helper15901590/game-story/项目说明与二次开发指南.md

# 冒险故事机（Story Machine / iStory）项目说明与二次开发指南

> 整理日期：2026-11-13
> 依据材料：V1.0、V2.0 两个版本目录中的固件源码、PRD、NFC 数据结构表、编码命令、BOM、烧录教程与示例内容。
> 用途：帮助新接手的人快速理解项目，并为二次开发（内容 / 固件 / 硬件 / 配套工具）做准备。

---

## 0. 一页速览

**这是什么**：一台无屏、以 NFC 卡片为载体的儿童互动有声故事机。孩子把故事卡插入卡槽，机器读取卡内的"剧情节点表"，再从 TF 卡播放对应的音频；故事进行到决策点时，旋转旋钮试听选项、按下确认，实现"选择推动剧情"的互动叙事。

**核心原理一句话**：

> NFC 卡里存的不是音频，而是**剧情跳转表**；音频全部放在 TF 卡里。MCU 读卡决定"现在播哪个文件、播完跳到哪里"。

**产品形态**：
- 硬件：圆角小主机 + 多功能旋钮（旋转/按压/长按）+ 插卡槽 + 知识/插播按键 + RGB 状态灯 + Type-C 充电。
- 内容：一张 NFC 卡 = 一个故事；TF 卡里一个 5 位数字文件夹 = 一个故事的全部音频。
- 商业模式（投资人材料）：硬件为入口、NFC 故事卡为持续复购内容（剃刀-刀片模式）。

**两代版本**：
| 版本 | 目录 | 核心玩法 | 提供物 |
|---|---|---|---|
| V1.0 选项插播 | `V1.0 选项插播 20251125/` | 每个选项(O)可插播知识音频(K) | 完整开发+生产资料（源码、PCB、BOM、语音芯片固件、TF 内容） |
| V2.0 主音插播 | `V2.0 主音插播 20251213/` | 插播绑定到主线音频(M)，并新增 3-5 岁"ISTORY mini"模式 | **只有烧录 hex 与文档，没有源码** |

**技术栈**：Nuvoton MS51EC0AE（1T 8051，32KB Flash / 2KB SRAM，24MHz）· Keil C51 · RC522（SPI，NTAG216 卡）· WT2003H4-16S（UART 语音芯片，读 TF 卡）· 2000mAh 锂电池 · 编码器旋钮。

---

## 1. 目录结构怎么读

```
game story/
├─ V1.0 选项插播 20251125/
│  ├─ audio storyV1.0.md          ← V1 产品需求文档（PRD V4.0 + 编码规范附录）
│  ├─ audio storyV0.1~V0.3.md     ← 早期需求迭代稿（历史参考）
│  ├─ NFC写入教程/                 ← NFC 命令写入视频、数据结构表、命令示意
│  ├─ 代码烧录1114/                ← 烧录演示照片/视频、量产 hex、TF卡文件.zip
│  │   └─ Story_machine 251127 L3/Story_machine V1.hex
│  ├─ 其他资料/                    ← 样音（小红帽/我的世界/村庄任务/晚安妈妈）、调研、路演稿
│  ├─ 内容改编/                    ← 四大名著原文（内容改编素材）
│  ├─ 结构与外观/                  ← 外观渲染图、结构件 ZIP（V0.1~V1.1）、紧固件清单
│  └─ 开发生产文件/故事机251117 L1.0/
│      ├─ 开发文件/
│      │   ├─ 硬件/Story_machine V1.3/   ← Altium PCB 源文件
│      │   ├─ 软件/Story_machine/        ← ★ 主控 Keil 工程（本项目的核心代码）
│      │   └─ 语音/                      ← WT2003 芯片手册、语音芯片固件 .fw、NFC数据结构.xlsx
│      ├─ 生产文件/                      ← 量产 hex、BOM、PCB、拼板/贴片资料
│      └─ 说明.txt                      ← "生产文件用于生产，开发文件除开发人员请勿动"
│
└─ V2.0 主音插播 20251213/
   ├─ audio storyV2.0.md          ← V2 PRD（ISTORY 6-12 岁 + ISTORY mini 3-5 岁）
   ├─ 优化记录.docx                ← ★ V2 改版决策清单（信息量最大）
   ├─ [1]代码及烧录/IStory V2.0 20251209.hex   ← 仅 hex，无源码
   ├─ [2]NFC编码及写入/            ← V2 NFC 数据结构 L2.0
   ├─ [3]配件及规格/ [4]结构及外观/ ← 与 V1 基本相同的硬件/结构资料
   └─ [5]内容及示例/               ← 村庄任务示例（脚本+音频+编码命令）、四大名著
```

**最重要的三个目录**：
1. `V1.0 .../开发文件/软件/Story_machine/` —— 唯一一份主控源码。
2. `V1.0 .../开发文件/语音/` —— 语音芯片固件与 NFC/TF 数据规范。
3. `V2.0 .../优化记录.docx` —— 理解 V2 为什么这样改的钥匙。

---

## 2. 系统架构与硬件

### 2.1 系统框图

```
        ┌──────────────┐   SPI(软件模拟)   ┌──────────────┐
        │              │◄─────────────────►│  RC522 Mini  │◄──► NTAG216 故事卡
        │              │  RST/NSS/SCK/MOSI │  (13.56MHz)  │      (卡片插入卡槽，
        │ MS51EC0AE    │  /MISO            └──────────────┘       压住触位开关)
        │ 8051 24MHz   │
        │              │   UART 9600        ┌──────────────┐
        │              │───────────────────►│ WT2003H4-16S │──► TF 卡（音频）
        │              │  TX/RX/BUSY        │  语音芯片     │──► WT8302 功放 ──► 4Ω3W 喇叭
        │              │                    └──────────────┘
        │              │   GPIO
        │              │── 编码器 A/B + 按压、插卡触位开关、插播按键
        │              │── RGB 三色灯（R/G/B）、按键指示灯
        │              │── 电池检测（TP4056：CHRG/STDBY）、ADC 电量
        └──────────────┘
                 │
              Type-C 充电 / 2000mAh 锂电池
```

### 2.2 关键器件（来自生产 BOM）

| 类别 | 型号/规格 | 说明 |
|---|---|---|
| MCU | Nuvoton **MS51EC0AE**（SOP-28，32KB Flash，2KB SRAM，1T 8051） | 无外挂 Flash；Keil 工程按 24MHz 主频 |
| NFC 读头 | **RC522 Mini** 模块 | BOM 注明"定制去掉模块上的 LED 以降低功耗" |
| NFC 卡 | **NTAG216**（国产 868 字节 / 进口 888 字节） | ISO14443-3A，带密码保护 |
| 语音芯片 | **WT2003H4-16S**（SOP-16，带 TF 卡版本 A02） | 主控固件 `WTC221031-72-A02V2.05.fw`，校验码 86A87450 |
| 功放 | WT8302（SOP-8） | 驱动 4Ω/3W 喇叭 |
| 充电管理 | TP4056（1A） | 提供 CHRG / STDBY 状态给 MCU |
| LDO | HL5933XR（SOT-23，500mA） | 3.3V 稳压 |
| 旋钮 | 三色 RGB 带按压编码器 `ED1273S-RGB-24P-24LC-Y20A7` | 旋转 + 按压 + 三色灯 |
| 存储 | TF 卡 C10（BOM 为 16GB；PRD 写 32GB） | FAT32，存放全部音频 |
| 电池 | 2000mAh 3.7V 刀片/立柱式锂电池（带保护板） | 满电 4.2V |
| 喇叭 | 4Ω 3W（V1 带线端子；V2 为 Φ2.5cm 内磁喇叭） | |
| 按键 | 6×6×9 带灯轻触按键 | 插播/知识键，带黄色指示灯 |

### 2.3 MCU 引脚分配（来自 `MS51_16K.h` 与 `GPIO_Init()`）

| 功能 | 引脚 | 配置 |
|---|---|---|
| RC522 RST | P2.3 | 推挽输出 |
| RC522 NSS(CS) | P1.1 | 推挽输出 |
| RC522 SCK | P1.2 | 推挽输出 |
| RC522 MOSI | P3.5 | 推挽输出 |
| RC522 MISO | P2.1 | 准双向 + 上拉 |
| 语音芯片 TX（MCU 发） | P0.6 | 推挽输出（UART0 TX） |
| 语音芯片 RX（MCU 收） | P0.7 | 输入（UART0 RX） |
| 语音芯片 BUSY | P0.4 | 输入；**播放时为高，空闲为低** |
| 编码器 A 相 | P3.0 | 外部中断 INT0，下降沿 |
| 编码器 B 相 | P1.7 | 外部中断 INT1，下降沿 |
| 旋钮按压键 | P3.4 | 准双向 + 上拉 |
| 插卡触位开关（NFC 键） | P0.3 | 准双向 + 上拉；**卡插入=按下** |
| 插播/知识按键 | P3.3 | 按键输入 |
| 插播按键指示灯 | P2.4 | 推挽输出 |
| RGB 灯 R / G / B | P0.1 / P0.0 / P1.0 | 共阴，**1=亮，0=灭**（PWM 做呼吸灯） |
| 充电检测 CHRG | P2.5 | 输入 + 上拉；充电时=0 |
| 充满检测 STDBY | P1.4 | 输入 + 上拉；充满时=0 |
| 电池电压采样 | P0.5 | ADC（代码使能 CH4） |

> 烧录：板上有 5Pin 排针（3.3V / GND / RX / TX / GND），用 **Nu-Link Plus** 连接，配合 Nuvoton 工具/Keil 烧录。详见 `代码烧录1114/烧录代码教程.mp4` 与 1/2/3.jpg。

---

## 3. 主控固件（V1.0 源码）

### 3.1 工程与构建

- 工程：`.../开发文件/软件/Story_machine/Project/Story_machine.uvproj`
- IDE/编译器：**Keil uVision 5（V5.24.2）+ C51 PK51 9.57**；CPU 选 `MS51EC0AE`，时钟 24MHz。
- 输出：`Output/Story_machine V1.hex`；构建日志显示 `code=17458 bytes, data=42.4, xdata=511`。
- 源码编码：**GBK**（用 UTF-8 打开会乱码，需转码或用支持 GBK 的编辑器）。
- 调试宏：`UART0_DEBUG`、`RC522_DEBUG` 默认均为 0（在 `MS51_16K.h` 中）。注意 UART0 与语音芯片共用（P0.6/P0.7），打开调试打印会把日志同时发给 WT2003，可能干扰播放，调试时需注意。

### 3.2 文件职责

| 文件 | 职责 |
|---|---|
| `APP_Driver/Main/main.c` (1482 行) | **业务核心**：主循环、按键功能分发、故事状态机、休眠/低电、LED 调度 |
| `APP_Driver/Main/Function_Loop.c` | 早期框架，基本全部注释，可忽略 |
| `APP_Driver/RC522/RC522.c / RC522.h` | RC522 底层驱动（SPI 时序、寄存器、寻卡/防冲突/读写/密码认证） |
| `APP_Driver/RC522/RC522_Function.c` (1141 行) | 业务封装：`Rc522_Read_NTAG216_Full()` 读一页（底层返回16字节，仅用前4字节）、`Rc522_NTAG216_Password_Verify()` 验证密码+验证码 |
| `APP_Driver/WT2003/WT2003.c` | 语音芯片 UART 协议封装（A3/A4/A5/B1/AA/AB/AE/B6） |
| `APP_Driver/KEY/Key.c` | 按键扫描：短按/长按/拨码型，输出键值 |
| `APP_Driver/LED/LED.c` | 12 种灯效模式 + 提示灯 + PWM 呼吸灯 |
| `APP_Driver/Sleep/Sleep.c` | 掉电休眠、引脚唤醒（旋钮键/充电插入等） |
| `Library/Device/...` | Nuvoton MS51 官方头文件/SFR 宏（引脚别名也在这里） |
| `Library/StdDriver/...` | Nuvoton 标准外设库（GPIO/UART/ADC/Timer/I2C/SPI/EEPROM 等） |

### 3.3 主循环与中断

`main()` 初始化后进入死循环：

```c
while (1) {
    Encoder_Process();          // 编码器事件锁
    key_scan();                 // 按键扫描（Timer 计数去抖）
    utime_1s_function();        // 1s 计时：休眠 / 60s、120s 提示 / 180s 关机
    KEY_function();             // ★ 所有业务按键分发
    volume_control_funtion();   // 调音量后 5s 播放"噔"提示音
    busy_end_clr();             // ★ 检测 BUSY 下降沿，推进故事状态机
    LED_function();             // 电量/充电灯逻辑
    LED_MODE_Select();
    LED_PWM_Duty_RUN_program();
    TIPLED_MODE_Select();
}
```

- **Timer0**：约 2.738ms 中断，390 次 ≈ 1s（系统时基）。
- **Timer1**：约 2.73ms 中断，39 次 ≈ 100ms（按键/LED 扫描时基）。
- **UART0 中断**：接收语音芯片应答到 `RevBuffer`。
- **INT0/INT1**：编码器 A/B 相，产生顺时针 `0xD0` / 逆时针 `0xD1`。
- **Pin Interrupt**：休眠唤醒。

### 3.4 键值定义

| 键值 | 含义 | 触发条件 |
|---|---|---|
| `0xB0` | 拔卡（触位开关松开） | P0.3 松开 40ms |
| `0xB1` | 插卡（触位开关按下） | P0.3 按下 40ms |
| `0xC0` | 旋钮短按 | 松开时判定（<1s） |
| `0xC1` | 旋钮长按 | 按住 ≥ 40000 次扫描（代码注释称约 1 秒，PRD 写 3 秒；实际时长取决于主循环周期，需实测） |
| `0xD0` | 旋钮顺时针 | INT0 中断 |
| `0xD1` | 旋钮逆时针 | INT1 中断 |
| `0xE0` | 插播/知识键短按 | 松开时判定 |
| `0xE1` | 插播/知识键长按 | 按住 ≥ 1s |

### 3.5 V1 故事播放状态机（核心）

关键变量：

| 变量 | 含义 |
|---|---|
| `Story_Number` | 故事编号（由 NFC 页 04 的 BCD 数据解码，1~9999） |
| `Story_nodes_state` | 当前 M 节点号（1~255） |
| `branches_ALLNumber` | 当前节点选项数（0~3） |
| `branches_Number` | 当前试听到第几个选项（0=未选） |
| `branches_play_flag` | 0=空闲/播完，1=主音频播放中，2=暂停，3=验证音效播放中 |
| `End_play_flag` | 1=待播剧终音效，2=剧终音效播放中 |
| `b_Automatic_Continuation` | 无选项时自动连播下一 M |
| `B_Skipped_flag` | 已执行"跳过" |
| `NFC_flag` / `KEY_NFC_flag` | 开机时卡是否已插入 / 读卡失败标记 |

流程（简化）：

```
插卡(0xB1)
  └─ 密码验证 + PACK 校验（22）
      ├─ 失败：红灯闪两下 + 音效 0004，进入"音量模式"
      └─ 成功：白灯常亮
          读页 04 → 故事编号
          读页 05(M1) → 选项数
          播放 0005"验证通过" → 播完自动播放 M1
              ├─ M 播完且无选项：
              │    ├─ block2=0 → 标记剧终，播放 0011 后回到待机
              │    └─ block2≠0 → 自动连播该 M 节点（线性播放）
              └─ M 播完且有选项：
                   ├─ 旋转 → 循环试听 O1..On（播放文件 "<M>1..<M>3"）
                   │    └─ 短按插播键 → 播 K 音频 "<M>A..<M>C"（V1 选项插播）
                   └─ 按下旋钮 → 按所选 O 的跳转目标进入下一 M
拔卡(0xB0)
  └─ 停止播放 + 音效 0006 + 呼吸灯 + 清空全部状态
```

补充规则（V1 代码）：
- 短按旋钮：主音频播放中=暂停/续播；选项试听中无效；播完后=确认当前选项。
- 长按插播键：跳过当前主音频剩余部分（若在自动连播节点则只跳一次）；结局音频不可跳过。
- 长按旋钮：关机（播放 0002）。
- 未插卡时旋转旋钮=音量 10 级（映射 0,5,10,13,16,19,22,25,28,31）；插卡且主线播完时旋转=切换选项。
- 开机后若卡已插着，播完开机音效自动触发一次读卡。

### 3.6 LED / 电源 / 休眠（V1）

- 灯效编号：1 全灭、2 白色呼吸、4 白常亮、5 红灯闪两下接灭、6 红灯闪两下接呼吸、7 红常亮、8 绿常亮、9 蓝常亮、11 蓝闪两下接白常亮、12 蓝闪两下接红常亮。
- 充电：充电中红灯常亮，充满绿灯常亮；充电时不进入休眠。
- 低电：代码用 ADC 均值判断，阈值 2200/2100（注释称 3.5V/3.3V，实际是 ADC 码值），≤20% 红灯闪+音效 0009，≤10% 音效 0010 后自动关机。
- 休眠：开机空闲 60s/120s 播 0008 提醒，180s 自动关机；关机状态 10s 后 MCU 掉电，由引脚中断（旋钮键/充电插入）唤醒。

> 注意：PRD 的电量百分比是产品口径，代码里没有库仑计，只有电压估算，实际阈值需按电池曲线标定。

### 3.7 代码风格与注意点

- 典型 8051 风格：大量全局变量、`bit` 标志、`UINT8/UINT16` 自定义类型；业务逻辑集中在 `main.c` 的 `KEY_function()` 与 `busy_end_clr()`。
- 大量中文注释，但有拼写/乱码；`tempCodeRunnerFile.c/h` 是编辑器残留空文件。
- 无 RTOS、无单元测试，全靠整机联调；改动后必须做完整回归（见 §9.4 测试清单）。

---

## 4. 语音芯片 WT2003H4-16S 与音频协议

### 4.1 分工

MCU 不直接解码音频：所有播放指令通过 **UART0（9600 8N1）** 发给 WT2003H4-16S，芯片自己读 TF 卡、解码 MP3/WAV，经 DAC/SPK 输出（固件启动时发 `B6 01` 切到 DAC 输出，再经 WT8302 功放）。`BUSY` 引脚高电平表示正在播放，是故事状态机的关键输入。

### 4.2 固件中实现的命令（`WT2003.c`）

帧格式统一：`7E | 长度 | 命令 | 参数... | 校验和 | EF`，校验和 = 从"长度"到最后一个参数字节之和（取低 8 位）。

| 命令 | 作用 | 本项目用途 |
|---|---|---|
| `A3` | 指定根目录文件名播放 | 预留 |
| `A4` | 指定文件夹按索引播放 | 预留（插播按键旧方案） |
| `A5` | 指定文件夹内文件名播放 | **主用**：故事音频、系统音效 |
| `AA` | 暂停/继续 | 短按旋钮暂停/续播 |
| `AB` | 停止 | 预留 |
| `AE` | 音量 0~31（掉电记忆） | 10 级音量映射 |
| `B1` | 播放中插播（播完自动恢复原曲） | V1 PRD 曾设想，代码未启用 |
| `B6` | 输出切换：00=SPK，01=DAC | 开机切 DAC |

### 4.3 三种播放函数

```c
// 1) 故事音频：文件夹=故事编号，文件=节点号+选项位
volume_Play_TF(Story_Number, Node, Option);
//   发送 "00" + 3位故事号 + 3位节点号 + 1位选项号
//   例：volume_Play_TF(1, 4, 0) → 文件夹 00001，文件 0040.mp3（M4 主音频）
//       volume_Play_TF(1, 4, 2) → 0042.mp3（M4 的 O2）
// 2) 选项对应的知识音频（V1）：选项 1/2/3 → 字母 A/B/C
volume_Play_TF_option(Story_Number, Node, Option);
//   例：(1, 4, 1) → 004A.mp3（M4 的 K1）
// 3) 系统音效：固定文件夹 SYSTE
volume_Play_TF_SYS(0,0,0,5);   // → SYSTE/0005.mp3
```

### 4.4 TF 卡目录与命名（V1 实机口径）

```
TF 卡根目录/
├─ SYSTE/                 ← 系统音效，固定 5 字符大写
│   ├─ 0001.mp3  开机
│   ├─ 0002.mp3  关机
│   ├─ 0003.mp3  音量调节
│   ├─ 0004.mp3  读卡错误
│   ├─ 0005.mp3  读卡成功
│   ├─ 0006.mp3  拔卡
│   ├─ 0007.mp3  跳过
│   ├─ 0008.mp3  等待 1/2 分钟提醒
│   ├─ 0009.mp3  电量≤20%
│   ├─ 0010.mp3  电量≤10%
│   └─ 0011.mp3  剧终
└─ 00001/                 ← 故事文件夹：首位 0 + 故事编号
    ├─ 0010.mp3          M1 主音频
    ├─ 0011.mp3 / 0012.mp3 / 0013.mp3   M1 的 O1/O2/O3
    ├─ 001A.mp3 / 001B.mp3 / 001C.mp3   M1 的 K1/K2/K3（V1）
    ├─ 0020.mp3          M2 主音频
    └─ ...
```

命名规则：**文件前 3 位 = M 节点号，第 4 位 = 类型**（`0`=主音频/结局，`1~3`=选项，`A~C`=知识插播）。结局音频与普通 M 共用命名，只是 NFC 数据标记为终止节点。

音频要求（文档口径）：MP3/WAV，8kHz~44.1kHz，单声道，8kbps~320kbps；推荐 MP3。实机样音多为 32~64kbps 单声道。

---

## 5. NFC 数据协议（NTAG216）

### 5.1 存储布局（先厘清"页"与"扇区"）

NTAG216 的读写单位是 **页(page)，每页 4 字节**；NFC Tools Pro 的 `A2:XX:....` 就是"向第 XX 页写 4 字节"。

项目文档里说的"每个 M 节点占 1 个扇区 / 4 个 Block"，实际指的是**一页 4 字节**，不是 16 字节。固件 `Rc522_Read_NTAG216_Full(page)` 底层 `PcdRead()` 一次会返回 16 字节（4 页），但业务代码**只用 `RevBuffer[0..3]` 这 4 个字节**，后面的数据被忽略。理解了这一点，写卡地址才不会算错。

| 页地址 | 用途 |
|---|---|
| 00~03 | 厂家信息 / UID / 静态锁（不可改） |
| 04 | 故事元数据（4 字节：故事编号高/低 + 主音频数量高/低） |
| 05 起 | M1、M2、M3… 每个 M 节点占 **1 页（4 字节）**；页号 = M 节点号 + 4 |
| E3~E6 | 配置区：CFG0 / CFG1 / 密码(PWD) / 验证码(PACK) |

### 5.2 页 04：故事元数据

| 字节 | 字段 | 说明 |
|---|---|---|
| 1 | 故事编号高位 | **BCD 编码**的两位十进制数（如 0x10 表示"10"） |
| 2 | 故事编号低位 | 同上（如 0x01 表示"01"） |
| 3 | 主音频数量(高) | 十六进制，含结局音频；最大 0xFF |
| 4 | 主音频数量(低)/模式 | V1 固定 00；V2 用作模式位（01=有插播，02=无插播，见 §7.2） |

故事编号拼接 = 高位字符串 + 低位字符串，例如 `0x10,0x01 → "1001"`；对应 TF 文件夹 `01001`（前面补固定 0）。
V1 固件用 `base_decoding()` 把两个字节按"每半字节一位十进制"还原，因此高位/低位只能是 0x00~0x99 的 BCD 值，故事编号范围 0000~9999。

### 5.3 页 05+：节点跳转表

每个 M 节点 1 页，共 4 字节：

| 字节 | 固件字段 | 含义 |
|---|---|---|
| 1 | `RevBuffer[0]` | 当前 M 的选项数 00~03；V2 高半字节=插播标志（如 0x13 = 有插播 + 3 个选项） |
| 2 | `RevBuffer[1]` | 有选项时：O1 跳转目标；无选项时：下一 M 节点号（线性连播）；字节1=0 且本字节=0：**终止节点** |
| 3 | `RevBuffer[2]` | 有选项时：O2 跳转目标 |
| 4 | `RevBuffer[3]` | 有选项时：O3 跳转目标 |

> 注意第 2 字节的双重含义：有选项时=O1 目标；无选项时=下一 M。代码正是这样分支的。

节点号 = 音频文件前 3 位数字（001~255）。例如 M4 的音频是 `0040.mp3`，节点号 4；跳转目标写 `04`。

**终止节点**：`00 00 00 00`。播完后播放 `SYSTE/0011.mp3`（V1 参数是 `volume_Play_TF_SYS(0,0,1,1)`），然后回到待机。结局音频不可跳过。

### 5.4 卡密码与防复制（配置页 E3~E6）

| 页 | 数据 | 含义 |
|---|---|---|
| E3 (CFG0) | `04 00 00 00` | 按项目约定为"启用密码保护"（AUTH0=04，从第 4 页起需认证） |
| E4 (CFG1) | `00 05 00 00` | 允许输错 5 次等配置 |
| E5 (PWD) | `31 35 39 30` | 密码 ASCII **"1590"**（ISTORY mini 为 "0951"） |
| E6 (PACK) | `32 32 00 00` | PACK/验证码 ASCII **"22"** |

V1 固件硬编码：
```c
uint8_t NFC_password1[4] = {0x31,0x35,0x39,0x30}; // "1590"
unsigned char NFC_pack[2] = {0x32,0x32};           // "22"
```
读卡流程：寻卡→防冲突→选卡→`PcdNTAG216_Authenticate_Enhanced(password)`→比对 PACK。PACK 不等于 "22" 即判为无效卡。

> 说明：项目文档把 E3 最后一字节描述为"00=启用 / FF=关闭"。按标准 NTAG216 语义，关闭保护应把 AUTH0 设为 `FF`（即 `A2:E3:FF:00:00:00`），与项目给出的 `04:00:00:FF` 不一致。现有量产卡按项目命令操作，二次开发改密码区前务必用实卡/读卡器验证，避免把卡锁死。

> PRD 提到"动态码防复制"（首次识别写入随机码），**当前固件没有实现**，只是固定密码 + 固定 PACK。二次开发若要做防克隆，需要自己加"首次写随机码 + 每次校验"的逻辑。

### 5.5 写入工具与命令

工具：Android 应用 **NFC Tools Pro** → 其他 → 先进的 NFC 命令 → 选 **TAG TYPE2 (ISO14443-3A)** → **Write4bytes**。

命令格式：
```
A2:页号:字节1:字节2:字节3:字节4        // 向该页写 4 字节
1B:31:35:39:30                        // 验证密码 1590（已加密卡必写第一行）
多条命令用英文逗号连接
```

**启用密码 + 写入完整故事（示例）**：
```
A2:E3:04:00:00:00,A2:E4:00:05:00:00,A2:E5:31:35:39:30,A2:E6:32:32:00:00
```

**关闭密码（量产调试/重烧）**：
```
1B:31:35:39:30,A2:E3:04:00:00:FF,A2:E4:00:05:00:00,A2:E5:00:00:00:00,A2:E6:00:00:00:00
```

**《我的世界》示例（V1）**：
```
1B:31:35:39:30,A2:04:00:02:07:00,A2:05:03:02:05:06,A2:06:03:03:03:03,
A2:07:00:04:00:00,A2:08:03:05:05:05,A2:09:03:06:06:06,A2:0A:03:07:08:09,
A2:0B:00:00:00:00,A2:0C:00:00:00:00,A2:0D:00:00:00:00
```
解读：故事编号 0002，主音频 7 条；M1 有 3 个选项→M2/M5/M6；M2 3 个选项→M3/M3/M3；M3 无选项→M4；M4 3 个选项→M5/M5/M5；M5 3 个选项→M6/M6/M6；M6 3 个选项→M7/M8/M9；M7~M9 为终止节点。

---

## 6. 内容制作完整流程（从脚本到整机）

### 6.1 写脚本（M / O / K / E 结构）

- `M`：主线剧情节点，从 M1 开始连续编号。
- `O`：决策点选项，每个 M 最多 3 个，命名 Ox-y（如 O1-1、O1-2、O1-3）。
- `K`：知识插播，V1 与选项一一对应（O1→K1）；V2 改为绑定到 M（M4→K4，文件 004A）。
- `E`：结局，逻辑上视为 M，NFC 中用 `00 00 00 00` 标记。
- 设计模式：改编原著多用"主线汇聚型"（不同选择最终回到同一 M）；原创故事可用"完全分支型"（各走各的结局）。
- 每个 M 节点最多 3 个选项；单故事建议 M+O+K 总音频 100~120 条（V1 PRD）。

参考模板：`V1.0 .../其他资料/小红帽.../小红帽故事脚本-线性播放版.md`（含完整 M/O/K/E 示例与末尾编码命令）。

### 6.2 配音与音频处理

1. 按脚本逐条生成/录制音频，导出 MP3（单声道）。
2. 按 §4.4 命名：M 节点 `NNN0.mp3`、选项 `NNN1~3.mp3`、知识 `NNNA~C.mp3`。
3. 系统音效放 `SYSTE/0001~0011.mp3`。
4. 建议每条音频控制在 60 秒以内（状态机按秒计时，过长会进入等待提示逻辑，见 §3.6）。

### 6.3 规划 NFC 跳转表

为每个 M 节点写一行四字节：
```
[选项数] [O1目标/下一M] [O2目标] [O3目标]
```
把目标写成节点号（=音频前三位）。终止节点写 `00 00 00 00`。
再写页 04：故事编号 BCD 高位/低位 + 主音频数量 + 00。

### 6.4 写卡

按 §5.5 用 NFC Tools Pro 依次写入（建议顺序：密码 → 04 元数据 → 05 起节点表 → 读回校验）。
写完后用手机读卡核对，再上机测试。

### 6.5 拷 TF 卡

FAT32 格式；根目录放 `SYSTE/` 与故事文件夹（如 `00001/`）；确保编号与 NFC 数据完全一致。建议量产前用脚本核对"文件名集合 = 跳转表引用集合"。

### 6.6 整机联调

插卡 → 听 0005 → M1 → 选项/插播 → 确认 → 逐节点走完 → 剧终 0011。至少覆盖：每个选项、每个结局、拔卡中断、暂停/续播、跳过、低电、充电。

### 6.7 案例：《小红帽》V1 完整映射

| 节点 | 音频 | NFC 跳转 | 说明 |
|---|---|---|---|
| M1 | 0010 | `02 03 02 00` | 2 个选项：O1→M3，O2→M2 |
| M2 | 0020 | `00 04 00 00` | 无选项，线性→M4 |
| M3 | 0030 | `00 04 00 00` | 无选项，线性→M4 |
| M4 | 0040 | `03 07 06 05` | 3 个选项：O1→E3(7)，O2→E2(6)，O3→E1(5) |
| E1 | 0050 | `00 00 00 00` | 胜利结局 |
| E2 | 0060 | `00 00 00 00` | 平安结局 |
| E3 | 0070 | `00 00 00 00` | 失败结局 |

对应页 04：`00 01 07 00`（故事 0001，主音频 7 条：M1~M4 + E1~E3）。
选项/知识文件：M1=0011/0012 + 001A/001B；M4=0041/0042/0043 + 004A/004B/004C。

---

## 7. V1.0 与 V2.0 的差异

### 7.1 产品与交互（据《优化记录.docx》与 V2 PRD）

| 项目 | V1.0（选项插播） | V2.0（主音插播） |
|---|---|---|
| 插播对象 | 选项 O 的配套知识 K（试听选项时按插播键） | **主线 M** 的配套知识（播 M 时按插播键） |
| 插播后行为 | 播完 K 进入等待，旋转可回选项 | 播完 K **自动重头播放当前 M**；插播中再按一次=取消并重头播 M |
| 插播灯 | 切到有 K 的 O 时闪亮 | 进入有插播的 M 时亮，播完该 M 熄灭 |
| 分支选择灯 | 选项等待时白色呼吸，确认后白常亮 | 播放故事时灯灭；选项等待白呼吸；切换"瞬闪" |
| 跳过 | 长按插播键 | 长按插播键（保留），但模式二删除插播功能 |
| 等待/暂停关机 | 60/120s 提醒，180s 关机 | 选项等待 3 分钟静默关机；暂停 30 分钟静默关机；无提醒音 |
| 低电 | ≤20% 声光提示；≤10% 关机 | ≤20% 只红灯闪 3 次（无音效）；≤10% 闪灯+关机音效后关机；没电不能开机 |
| 小夜灯 | 无 | 关机短按旋钮：暖黄→冷白→灭（3 小时自动关）；短按插播键：暖黄→灭 |
| 产品线 | 6-12 岁单线 | ISTORY（6-12，分支）+ ISTORY mini（3-5，无分支，旋钮顺序切小故事） |
| 系统音效编号 | 0001~0011 | 文档改为 1001~1009（6-12）/ 2001~2007（3-5），但 V2 未提供实际 SYSTE 样音，需以固件为准 |
| NFC 密码 | 1590 | 6-12：1590；mini：0951；PACK 均 22 |

### 7.2 NFC 编码变化（V2）

- 页 04 第 4 字节从"固定 00"变为模式位：**01=有插播（6-9 岁模式一）/ 02=无插播（3-5 岁模式二）**（见《优化记录》）。
- 节点页第 1 字节（选项数字段）的高半字节表示"该 M 是否有插播"：
  - `0x13` = 有插播 + 3 个选项；`0x10` = 有插播 + 0 个选项；`0x02` = 无插播 + 2 个选项。
  - V1 固件会把 `0x13` 当成 19 个选项，**V2 固件必然做了掩码/分支处理**（源码未提供）。
- 插播音频文件名固定为"当前 M 节点号 + A"（如 M4 → `004A.mp3`），不再对应某个 O。
- 3-5 岁 mini：页 04 第 1/2 字节改为"音频数量高位/低位（十进制）"，不做 M/O 跳转，仅做文件校验与顺序播放。

**V2 示例《村庄任务》编码**：
```
1B:31:35:39:30,
A2:04:00:01:07:01,
A2:05:02:02:03:00,   M1: 2 选项 → M2/M3
A2:06:00:04:00:00,   M2: 无选项 → M4
A2:07:00:04:00:00,   M3: 无选项 → M4
A2:08:10:00:00:00,   M4: 0x10 = 有插播、0 选项（004A）
A2:09:02:06:07:00,   M5: 2 选项 → M6/M7
A2:0A:00:00:00:00,   M6: 终止
A2:0B:00:00:00:00    M7: 终止
```
> **疑点**：M4（`0x10 00 00 00`）按现有规则会被判为"终止节点"，但脚本里 M4 之后还有 M5~M7。可能是 V2 固件对"有插播且无选项"另有解释（例如播完插播后顺序进入下一节点），也可能样例外包写错。二次开发前务必在实机上验证这一点。

### 7.3 文档之间已知的不一致（重要）

1. **系统音效编号**：V1 PRD 附录写 `SYSTE/1001~1010` 与 `2001~2007`；但 V1 固件与实机 TF 卡用的是 `0001~0011`。以固件/实机为准。
2. **插播 K 是否被删除**：V2 PRD 的"开发问答 Q1"说删除 K 类插播；但《优化记录》明确"删除选项 O 类插播改为主音频 M 类插播"，且 V2 示例有 `004A.mp3` 与 `0x10` 标志。应以《优化记录》+ 示例为准（K 仍存在，只是绑定对象从 O 变成 M）。
3. **故事编号容量**：PRD 说支持 5 位文件夹（00000~99999），但 V1 固件 `volume_Play_TF()` 只发送 3 位故事号，实际只支持 1~99（详见 §9.3）。
4. **节点上限**：PRD 说 255 个音频；V1 固件节点号百位取自故事编号，实际节点 ≤99。
5. **TF 卡容量**：PRD 写 32GB，BOM 写 16GB C10。
6. **长按开机时间**：PRD 写 3 秒，代码阈值是 40000 次扫描（注释称约 1 秒）。实际取决于主循环耗时，二次开发时建议统一为明确的定时器计时。

---

## 8. 烧录与生产流程

### 8.1 MCU 固件烧录

1. 安装 Keil C51（PK51 9.57）+ Nuvoton Nu-Link 驱动（`Project/Nu_Link_8051_Driver.ini`）。
2. 用 Nu-Link Plus 连接板上 5Pin（3.3V/GND/RX/TX/GND）。
3. 打开 `Story_machine.uvproj` → Rebuild → 生成 `Output/Story_machine V1.hex`。
4. 用 Nuvoton 烧录工具（或 Keil 内置 Flash 下载）烧录 hex；量产用 `生产文件/MCU主控程序/Story_machine 251117 L1.hex`，并核对 `校验码：56cc.txt`。
5. 上电自检：串口 9600 会打印 SPI 通信测试结果（若接串口）。

### 8.2 语音芯片固件

WT2003H4-16S 需要单独的语音芯片固件：`WTC221031-72-A02V2.05.fw`（校验码 86A87450）。按唯创（WT）官方工具/产测流程烧录，一般由语音芯片供应商或产线完成。

### 8.3 TF 卡量产

- 用 `代码烧录1114/TF卡文件.zip` 作为母盘模板（含 `SYSTE/` 与 `00001/`）。
- 量产时整盘克隆，确保 FAT32、文件名全大写/数字、无多余文件。
- 每张故事卡对应一个故事文件夹；多故事可放多个文件夹，卡内 NFC 指向哪个就播哪个。

### 8.4 硬件生产

- PCB：`Story_machine V1.31.PcbDoc`（96×75×1.2mm 双面板，两块拼板）；贴片资料含 Pick&Place CSV、BOM（含报价）。
- 结构：`结构与外观/结构设计/` 下有 V0.1~V1.1 多轮 ZIP（塑件、整机原件），最终版为 V1.1 1201（删除右侧按键）。
- 首批在嘉立创贴片；WT2003、WT8302、LDO、编码器等需自备邮寄（见 BOM 备注）。
- RC522 模块需去掉板载 LED 降功耗（可工厂拆或定制）。

### 8.5 出厂检查建议

1. 按键/旋钮/灯效全检。
2. 插卡读卡成功率（不同卡、不同插入深度）。
3. 每个故事节点跳转正确、剧终回到待机。
4. 充电/低电/自动关机。
5. 休眠电流（RC522 已 `RC522_Off()`、语音芯片待机功耗）。
6. 喇叭无异响、音量 10 级可用。

---

## 9. 二次开发指南

### 9.1 先确定你要改哪一层

| 路线 | 是否改固件 | 工作量 | 典型需求 |
|---|---|---|---|
| A. 只做新故事内容 | 否 | 小 | 新故事卡、TF 内容、配音、NFC 写卡 |
| B. 改交互/功能 | 是 | 中~大 | 新按键逻辑、进度记忆、蓝牙/WiFi、屏幕 |
| C. 改硬件 | 是（可能） | 大 | 新 PCB、换 MCU、加传感器、改结构 |
| D. 做配套工具 | 否 | 中 | 脚本→NFC 命令生成器、音频命名校验器、批量写卡工具 |

**最现实的切入点**：先用路线 A 跑通"脚本→音频→NFC→TF→整机"全流程；再决定是否动固件。

### 9.2 环境准备清单

- [ ] Keil uVision 5 + C51 编译器（PK51 9.57 或更高）
- [ ] Nuvoton Nu-Link Plus + NuMicro ICP/Keil 驱动
- [ ] 一台 V1.3 主板（或整机）+ 5Pin 烧录线
- [ ] RC522 + NTAG216 空白卡若干 + Android 手机（NFC Tools Pro）
- [ ] TF 卡（FAT32）+ 读卡器
- [ ] 音频工具（Audacity / ffmpeg）
- [ ] 串口工具（9600），用于看启动日志（可选）
- [ ] 万用表/可调电源，用于低电与充电测试

### 9.3 V1 源码的已知限制与风险（改代码前必读）

1. **故事编号实际只支持 1~99**
   `volume_Play_TF()` 里发送 `"00" + 3位故事号`，且 `file_tens = file/10`（不是 `%10`）。故事号 ≥100 时十位会变成多位数并溢出成非法字符。若要支持 `01001` 这类 5 位文件夹，必须重写该函数（改为发送 5 位十进制）。

2. **节点号实际只支持 1~99**
   `byte1_hundreds = file / 100`（用的是故事号而不是节点号），节点号 ≥100 时百位错误。若要支持 255 节点，需改为 `byte1/100`。

3. **UART 接收缓冲区溢出风险**
   `RevBuffer[30]`，但 `Serial_ISR()` 允许 `Uart_data_lenght` 累加到 80 才截断。若语音芯片返回超过 30 字节（或总线干扰），会越界写内存。建议把上限改为 30 或扩大缓冲区。

4. **防复制未实现**
   只有固定密码 1590 + 固定 PACK "22"。任何知道密码的人都能复制卡。若要防克隆，需要：
   - 首次识别时生成随机码写入 NTAG 用户区；
   - 每次读卡校验随机码；
   - 或改为"卡 UID 白名单 + 云端校验"。

5. **无数据校验/容错**
   NFC 内容没有 CRC；读到错误节点号可能跳转到不存在音频（表现为静音或播错）。建议加"节点号范围检查 + 音频存在性预检"。

6. **状态机与音频长度耦合**
   依赖 `BUSY` 引脚和 1s 计时；若音频过长/过短、或 BUSY 抖动，可能出现提前提示/误关机。改动时保留 `Busy_time` 的防抖逻辑。

7. **无进度记忆**
   拔卡即清空状态；PRD 的"NFC 卡记忆进度"未实现。要做需要把当前节点写回卡内固定页（注意 NTAG216 写寿命与密码）。

8. **UART0 与语音芯片共用**
   打开 `UART0_DEBUG` 会把调试字符串发给 WT2003，可能被当成命令。调试时建议改用 GPIO 模拟串口或临时断开语音芯片 TX。

9. **源码仅 V1**
   V2.0 只有 hex。若要在 V2 基础上改功能，必须：
   - 向原开发者索取 V2 源码；或
   - 以 V1 源码为基线，把 V2 的特性（主音插播、模式位、小夜灯、静默关机）重新实现。

10. **编码与工具链**
    Keil C51 对 8051 的 RAM/XDATA 很敏感（当前 xdata 已用 511B，SRAM 2KB）；新增全局数组/字符串要评估内存。源码 GBK，跨平台协作建议统一转 UTF-8 并加 `.editorconfig`。

### 9.4 建议的改造优先级

1. **做一套"内容工具链"**（最高性价比）
   - 输入：M/O/K/E 脚本（Markdown/Excel）；
   - 输出：`编码.txt`（A2 命令）、TF 文件命名清单、缺失文件检查报告。
   - 这样新故事上线不依赖人工算跳转表，避免写错卡。

2. **修复 V1 的故事号/节点号上限**
   - 让 `volume_Play_TF()` 支持 5 位文件夹与 3 位节点号；
   - 与 PRD 的 00000~99999 / 255 节点对齐。

3. **加"卡内容自检"**
   - 读卡后校验：故事号对应文件夹存在、M1 存在、所有跳转目标 < 主音频数；
   - 失败播 0004，避免静音卡。

4. **V2 功能回移或索取源码**
   - 主音插播（block1 高半字节 + `NNNA.mp3`）；
   - 04 block4 模式位；
   - 静默关机/小夜灯/低电策略。

5. **可选：配套 App/小程序**
   - 故事市场、写卡引导、进度同步（需给机器加 WiFi/BLE，属于路线 C）。

### 9.5 回归测试清单（每次改固件必跑）

- [ ] 开机音效 0001，呼吸灯正常
- [ ] 未插卡旋转=音量 10 级，每级有声，极限闪灯
- [ ] 插卡：验证成功 0005 → M1 自动播放
- [ ] 每个 M 的每个 O 都能试听、确认、跳转正确
- [ ] 每个 K 插播：按键灯亮/灭、播放、返回逻辑正确
- [ ] 线性连播（无选项 M）正确
- [ ] 每个结局播完 0011 回到待机
- [ ] 拔卡立即停止 + 0006 + 呼吸灯
- [ ] 暂停/续播、跳过、结局不可跳过
- [ ] 60/120s 提醒、180s 自动关机（V1）；V2 静默关机
- [ ] 低电 20%/10% 行为、充电红灯/绿灯
- [ ] 休眠 10s 后电流、按键唤醒
- [ ] 不同 NTAG216 卡（国产/进口）读写兼容
- [ ] 长时间播放（>30 分钟）无死机/内存异常

---

## 10. 关键文件索引

| 要找什么 | 路径 |
|---|---|
| 主控源码工程 | `V1.0 .../开发文件/软件/Story_machine/Project/Story_machine.uvproj` |
| 业务主逻辑 | `.../APP_Driver/Main/main.c` |
| NFC 读卡/密码 | `.../APP_Driver/RC522/RC522_Function.c` |
| 语音芯片协议 | `.../APP_Driver/WT2003/WT2003.c` |
| 引脚定义 | `.../Library/Device/Include/MS51_16K.h` |
| 量产 hex | `V1.0 .../生产文件/MCU主控程序/Story_machine 251117 L1.hex` |
| 语音芯片固件 | `V1.0 .../开发文件/语音/语音芯片主控/WTC221031-72-A02V2.05.fw` |
| NFC 数据结构（V1） | `V1.0 .../NFC写入教程/NFC数据结构251016.xlsx` |
| NFC 数据结构（V2） | `V2.0 .../[2]NFC编码及写入/NFC数据结构L2.0.xlsx` |
| V2 改版决策 | `V2.0 .../优化记录.docx` |
| 故事脚本模板 | `V1.0 .../其他资料/小红帽.../小红帽故事脚本-线性播放版.md` |
| 可运行示例（V2） | `V2.0 .../[5]内容及示例/村庄任务/00001/`（脚本+音频+编码.txt） |
| TF 卡母盘 | `V1.0 .../代码烧录1114/TF卡文件.zip` |
| BOM/成本 | `V1.0 .../生产文件/BOM表（配件清单）/Story_player V1.3 生产bom清单 1121（含报价）.xls` |
| 烧录演示 | `V1.0 .../代码烧录1114/烧录代码教程.mp4`、1/2/3.jpg |
| NFC 写卡演示 | `V1.0 .../NFC写入教程/NFC命令写入教程.mp4`、`命令示意.jpg` |

---

## 11. 待向原团队确认的问题

1. **V2.0 源码**是否可提供？没有源码，V2 功能只能重写。
2. V2 示例中 M4 `10 00 00 00` 的真实语义：是终止节点，还是"有插播+播完顺序进入下一 M"？
3. V2 的 `SYSTE` 音效编号最终是 1001~1009 / 2001~2007，还是沿用 0001~0011？
4. 页 04 第 4 字节的模式位（01/02）与 mini 的"音频数量"布局如何共存？以哪版为准？
5. 量产卡是否真的启用密码并保持只读？售后如何重烧？
6. 低电阈值的实测标定值（ADC 2200/2100 对应的实际电压/电量）。
7. "动态码防复制"是否计划实现？有无既定算法？
8. 结构最终版与模具状态（V1.1 1201 是否为量产版）。

---

## 附：一句话总结给接手的工程师

> 这是一台 **8051 + RC522 + WT2003 + TF 卡** 的离线互动故事机。固件只做三件事：读 NFC 跳转表、给语音芯片发 A5 播放命令、用 BUSY/按键推进状态机。**内容即数据**——新故事不需要改代码，只要按 M/O/K/E 规范做音频、算好 4 字节跳转表、写卡拷卡即可。真正的坑在：故事号/节点号的编码上限、V2 无源码、以及文档与实机的几处不一致。
