helper15901590/game-story/V1.0 选项插播 20251125/其他资料/小红帽-主线、选项、插播、结局音频V2.0/小红帽故事脚本-线性播放版.md

# 小红帽互动音频故事脚本 - 线性播放版

## 故事概述
**故事名称**: 小红帽  
**故事类型**: 安全与生活习惯类  
**结构特点**: M1分支选择 → M2/M3线性播放 → M4决策点 → 多结局

---

## 主线剧情

### M1: 出发前的叮嘱
**故事**: "很久很久以前！在一个阳光明媚的早晨，妈妈把一个装满新鲜出炉的蛋糕和黄油的篮子交给了小红帽。'亲爱的，'她温柔地说，'外婆生病了，你把这些带给她。记住，一定要沿着宽阔的大路走，那里人多安全。千万不要贪玩跑进森林，更不要和任何陌生人说话。'请旋转旋钮选择剧情，并按下确认按钮。"

**决策点**:
- **选项 (O1)**: "可是妈妈，森林里的小路近多了……"
  - **(K1)**: "小贴士：你知道吗？！选择捷径有时能节省时间，但也可能遇到意想不到的危险，因为偏僻的地方缺少保护和求助的机会。"
  - **主线**: "跳转到 M3"
- **选项 (O2)**: 小红帽说，"好的妈妈，我会走大路的。"
  - **(K2)**: "小贴士：小冒险家你要记住，人来人往的大路，通常比偏僻的小路更安全，因为周围人多，坏人不敢轻易出现，也更容易求助。"
  - **主线**: "跳转到 M2"

---

### M2: 大路上的帮助
**故事**: "小红帽走在宽阔的大路上，路上有许多行人，她还和几个认识的小伙伴打了招呼。走着走着，她不小心被一块石头绊倒，篮子里的蛋糕滚了出来。一位看起来很和善的阿姨急忙上前，帮她把蛋糕捡起来，拍掉上面的灰尘，放回了篮子里。这位阿姨微笑着问：'小朋友，你没事吧？你一个人要去哪里呀？'小红帽想起妈妈的话，礼貌地说：'谢谢阿姨，我没事。'然后继续向前走去。"

**决策点**: 无选项  
**线性播放**: 直接跳转到 M4（展示主音频连读功能）

---

### M3: 小路上的遭遇
**故事**: "小红帽为了快点到外婆家，选择了森林里的小路。路边开满了美丽的野花，她忍不住摘了一些。就在这时，一只大灰狼从树林里窜了出来，挡住了她的去路。'可爱的小姑娘，'大灰狼说，'你这么着急，是要到哪里去呀？'小红帽吓了一跳，想起妈妈的话，立刻转身，用尽全身力气跑回了大路。"

**决策点**: 无选项  
**线性播放**: 直接跳转到 M4（展示主音频连读功能）

---

### M4: 最后的抉择
**故事**: "小红帽终于来到了外婆家附近。她看到外婆的小屋就在不远处，但小屋的门半开着，里面似乎有些不对劲。小红帽心里有些不安，她应该怎么办呢？请旋转旋钮选择剧情，并按下确认按钮。"

**决策点**:
- **选项 (O1)**: 小红帽想："可能是外婆忘记关门了，我直接进去吧。"
  - **(K1)**: "小贴士：当发现异常情况时，不要贸然行动。直接进入可能有危险的地方，可能会让自己陷入困境。"
  - **主线**: "跳转到 E3"
- **选项 (O2)**: 小红帽想："我先在门外喊一声，看看外婆是否在家。"
  - **(K2)**: "小贴士：在进入一个可能有异常的地方之前，先通过声音确认情况，是一个既礼貌又安全的做法。"
  - **主线**: "跳转到 E2"
- **选项 (O3)**: 小红帽想："这里不对劲，我应该去找附近的猎人叔叔帮忙。"
  - **(K3)**: "小贴士：当感觉到危险时，不要独自面对，向有能力提供帮助的成年人求助，是保护自己和他人的明智选择。"
  - **主线**: "跳转到 E1"

---

## 结局阶段

### E1: 胜利结局
**结局**: "凭借小红帽的智慧和大家的帮助，成功抓住了大灰狼，救出了外婆，村庄又恢复了平静。保持警惕，并善于向他人求助，是战胜危险的关键。从此以后，小红帽更加小心谨慎，村庄也变得更加安全。"

### E2: 平安结局
**结局**: "虽然经历了一些波折和惊吓，但小红帽和外婆最终都安然无恙，享受了团聚的时光。时刻遵守安全规则，即使路上遇到一点小麻烦，也能保证自己最终平安。祖孙二人一起分享了美味的蛋糕，度过了美好的下午。"

### E3: 失败结局
**结局**: "因为一时的疏忽或错误的决定，小红帽陷入了危险之中，这是一个深刻的教训。一时的贪玩和疏忽，可能会带来意想不到的后果。记住这次教训，下次冒险一定会更顺利！这次经历让她明白，听从长辈的建议是多么重要。"

---

## 剧终音效
"冒险结束了，我的朋友...这真是一次愉快的冒险之旅，期待下次与你相见，再见。"

---
A2:04:00:01:07:00,A2:05:02:03:02:00,A2:06:00:04:00:00,A2:07:00:04:00:00,A2:08:03:07:06:05,A2:09:00:00:00:00,A2:0A:00:00:00:00,A2:0B:00:00:00:00,
