helper15901590/game-story/V1.0 选项插播 20251125/其他资料/我的世界/我的世界-杰杰与麦琪的冒险.md

## 故事基本信息

- **标题**：杰杰与麦琪的我的世界大冒险
- **适龄**：6 岁
- **剧情类型**：原创剧情（完全分支型）
- **叙述视角**：第一人称视角
- **风格类型**：游戏解说风格
- **故事主题 / 教育目标**：学会合作探索、勇敢面对挑战、懂得分享资源
- **主线带选项的 M 总数**：3 个
- **跳转逻辑说明**：采用完全分支型，M1 为公共开场，之后按顺序分成三条独立路径（森林分支使用 M2-M4，挖矿分支使用 M5，村庄分支使用 M6-M9）。

---

## 剧情脚本结构

### [M1 主线剧情（带选项）]

我是杰杰，今天我和我的好朋友麦琪一起进入了《我的世界》这个神奇的世界！哇，你看，到处都是方块，有绿色的草地方块，有棕色的木头方块，还有蓝色的天空！太阳从方块山头探出头，照得我们两个影子长长的。

麦琪兴奋地跳了起来，她说："杰杰，你看那边！有一座小山，还有一片森林！我们要去哪里探险呢？"她一边说一边掏出指南针和空地图，准备记录这次旅程。

我看了看周围，发现有三个方向可以走：左边有一条小路通向森林深处，那里有很多大树，还能听到鸟儿“啾啾”地唱歌；右边有一个小山坡，看起来可以挖矿，山壁上闪着银白色的矿点；正前方是一片开阔的草地，远处好像有个小村庄，烟囱正冒着暖暖的白烟。

"麦琪，你觉得我们应该先去哪里呢？"我问道。我把地图铺在地上，用石子在三个方向各放了一个符号。麦琪眨了眨眼睛，说："我也不知道，你来决定吧！不过记得我们要收集足够的资源，还要交到新朋友！"

- **结尾，引导到选择的口播**：
  嘿，小冒险家，你觉得我们应该先去哪里呢？是去森林里找木头，还是去山坡上挖矿，或者去前面的村庄看看有没有新朋友？

---

[O1-1 选项文本]
"我们决定去左边的森林，找一些木头来建造东西。"

[K1-1 插播文本]
  小朋友你知道吗？在《我的世界》里，木头是最万能的材料，工具、房子、火把几乎都需要它。现实里也一样，树木会吸收二氧化碳、制造氧气，让我们呼吸更舒服，还能变成书本、桌椅陪伴生活。所以我们砍树时要记得再种树苗，让森林一直保持茂密。好了，学会珍惜木头之后，回到选择里，你想怎么做呢？

---

[O1-2 选项文本]
"我们决定去右边的山坡，看看能不能挖到一些矿石。"

[K1-2 插播文本]
  挖矿就像一次深呼吸后的大探险：在游戏里，只有敲到铁、铜、钻石这样的矿石，我们才能合成更强的镐子和铠甲；现实中，铁轨、勺子、电线也都来自矿工叔叔在地下辛勤开采。挖矿时要一块一块慢慢挖，先插好火把、看清脚下，这种耐心也能帮助我们在学习时不急躁。知道这些小秘密以后，回到选择里，你会怎么做呢？

---

[O1-3 选项文本]
"我们决定去前面的村庄，看看能不能遇到新朋友。"

[K1-3 插播文本]
  村庄里每位村民都有自己的本领：农夫种小麦、铁匠锻造工具、图书管理员守护知识。和他们打招呼、互换礼物，就能学习到合作的力量。现实中也是这样，真心结交的朋友可以在你紧张时陪你深呼吸，也能分享好玩的点子。听起来是不是很温暖？那我们回到选择里，你想往哪边走呢？

---

- **跳转说明**：
  - 如果选择 O1-1 → 跳转到 M2（进入森林探索分支）
  - 如果选择 O1-2 → 跳转到 M5（进入挖矿冒险分支）
  - 如果选择 O1-3 → 跳转到 M6（进入村庄社交分支）

---

### [M2 主线剧情（森林探索分支 - 带选项）]

- **类型**：M（带选项）

- **文本（口播稿）**：
  我和麦琪走进了森林，哇，这里的树好高好大啊！我拿出我的小木斧，开始砍树。"咔嚓咔嚓"，木头一块一块地掉了下来，我们顺便搭了一个工作台，准备随时合成新工具。

  麦琪在旁边帮我收集木头，她一边捡一边数："一块、两块、三块……哇，我们已经收集了好多木头了！"她把木头按大小排好，还找到几根藤蔓说要做爬梯。

  继续往里走，我们发现一片野花田，蜜蜂在空中嗡嗡地飞。我刚想给麦琪拍照，突然听到"嘶嘶"的声音。我转头一看，哎呀！前面有一只绿色的苦力怕！它正一跳一跳地朝我们走过来，身上冒着绿光。

  麦琪有点紧张，她说："杰杰，苦力怕会爆炸的！我们怎么办？"她抓着背包带子，小声提醒我别太靠近。

  我看了看周围，发现我们有几个选择：可以快速跑开，躲到树后面；也可以试着用我们刚收集的木头搭一个简单的防御墙；或者我们可以慢慢后退，然后绕路走，还能顺便带着蜜蜂飞走的方向。

- **结尾，引导到选择的口播**：
  小冒险家，遇到危险的时候，我们要冷静思考。你觉得我们应该怎么做呢？

---

[O2-1 选项文本]
"我们决定快速跑开，躲到一棵大树后面。"

[K2-1 插播文本]
  一听到“嘶嘶”声就先跑开，可不是胆小，而是超聪明的安全反应。在游戏里，苦力怕靠太近就会爆炸，所以先闪到大树后再观察，能保护好我们的血条。现实生活也一样，如果闻到烧焦味、看到陌生人跟着自己，就要马上远离、告诉大人。记住咯，先保护自己，再想下一步。现在回到选择里，你会怎么做呢？

---

[O2-2 选项文本]
"我们决定用木头搭一个防御墙，保护自己。"

[K2-2 插播文本]
  拿起木头迅速搭出一面小墙，就像在野外搭帐篷一样，是把“动手能力”变成护盾的好办法。Minecraft 里的每一块方块都是工具，只要我们肯动脑筋，就能把普通木板排成防御堡垒。现实中也一样，遇到大风下雨时把桌椅搬到阳台内、用书本挡住强光，都是“创造力”的体现。会动手的小冒险家最厉害！回到选择里，你想试试吗？

---

[O2-3 选项文本]
"我们决定慢慢后退，然后绕路走，避开苦力怕。"

[K2-3 插播文本]
  绕路不代表放弃，而是换个聪明的角度继续前进。我们可以先退到花田里，等苦力怕离开，再找一条更安全的小路。生活中也常常要这样做：雨天改成室内游戏、堵车时换条街道走，都会让旅程更顺利。学会灵活转弯的小冒险家，才能走得更远。现在我们回到选择里，看看你想选哪一个？

---

- **跳转说明**：
  - 如果选择 O2-1 → 跳转到 M3（继续森林探索分支）
  - 如果选择 O2-2 → 跳转到 M3（继续森林探索分支）
  - 如果选择 O2-3 → 跳转到 M3（继续森林探索分支）

---

### [M3 主线剧情（森林探索分支 - 线性）]

- **类型**：M（线性无选项）

- **文本（口播稿）**：
  我和麦琪飞快地跑到一棵大树后面，躲了起来。我们屏住呼吸，听着苦力怕的脚步声越来越远。等到安全了，小狼突然从树丛里钻出来，叼着一根骨头，好像要加入我们的小队。

  "呼——"麦琪松了一口气，说："好险啊，我们躲过去了！"

  我点点头，说："是啊，有时候躲避也是好办法。现在我们安全了，可以继续收集木头了。"我顺手把树苗重新种回土里，还给小狼取名叫"咕噜"。

  我们继续在森林里探索，收集了很多木头。我还发现了一些苹果树，摘了几个红红的苹果，又挖了点黏土想做花盆。麦琪高兴地说："太好了，我们不仅有木头，还有苹果可以吃！等会儿我想在房子旁种花！"

  天慢慢黑了，我们决定用收集到的木头搭一个小房子，这样晚上就可以安全地休息了。我们分工合作，她搭墙、我放门，还给咕噜留了一个小门洞。

- **跳转说明**：本段为线性播放，无选项，直接跳转到 M4。

---

### [M4 主线剧情（森林探索分支 - 带选项）]

- **类型**：M（带选项）

- **文本（口播稿）**：
  我们用木头搭了一个可爱的小房子，有门、有窗户，还有一个小屋顶。麦琪兴奋地在房子里跳来跳去，说："杰杰，我们的房子好漂亮啊！我等会儿要把花盆放在窗边！"

  我看了看外面，天已经完全黑了，月亮升起来了。突然，我听到外面有"咯咯咯"的声音。我透过窗户往外看，发现有几只僵尸在房子外面走来走去，还有一只骷髅在树下拉弓。

  "麦琪，外面有僵尸！"我小声说。我把火把插得更亮，还让咕噜蹲在门口警戒。

  麦琪有点担心，问："它们会进来吗？要不要用箱子堵住门？"

  我们的房子很安全，但我想了想，我们有几个选择：可以待在房子里，等天亮僵尸就会消失；也可以从窗户往外看，观察一下僵尸的行为，顺便记录它们的动作；或者我们可以用收集到的木头加固一下房子，让它更安全，还能在屋顶搭射箭台。

- **结尾，引导到选择的口播**：
  小冒险家，晚上遇到僵尸，你觉得我们应该怎么做呢？

---

[O4-1 选项文本]
"我们决定待在房子里，等天亮僵尸就会消失。"

[K4-1 插播文本]
  关好门、点亮火把，在小屋里安静等待，其实是最稳妥的办法。僵尸在阳光下会自己冒烟消失，就像现实里许多困难只要耐心就能过去。我们等红绿灯、排队买东西，也是练习“先停一下再出发”。会耐心等待的小伙伴，心里才更踏实。现在我们回到选择里，你想怎么做呢？

---

[O4-2 选项文本]
"我们决定从窗户观察僵尸，看看它们是怎么行动的。"

[K4-2 插播文本]
  透过窗户偷偷观察，可以发现很多线索：僵尸走路慢、骷髅会在树荫里找阴凉，这样下次就更有经验。现实生活里，看蚂蚁搬家、看云朵变化，也能让我们发现自然界的小秘密。好奇又细心的眼睛，就是最棒的学习工具。知道了这一点，我们回到选择里，你会怎么做呢？

---

[O4-3 选项文本]
"我们决定加固房子，让它更安全。"

[K4-3 插播文本]
  把木板钉得更牢、在屋顶搭射箭台，就像给自己的家多穿一件厚外套。游戏里先做好防护，晚上就能放心休息；现实中我们出门前准备雨衣、写作业前把文具排好，也是同样的道理。懂得未雨绸缪的小朋友，遇到突发状况才不会慌张。现在，回到选择里，你想怎么做呢？

---

- **跳转说明**：
  - 如果选择 O4-1 → 跳转到森林分支的后续节点（可按需求扩展）
  - 如果选择 O4-2 → 跳转到森林分支的后续节点（可按需求扩展）
  - 如果选择 O4-3 → 跳转到森林分支的后续节点（可按需求扩展）

---

### [M5 主线剧情（挖矿冒险分支 - 带选项）]

- **类型**：M（带选项）

- **文本（口播稿）**：
  我和麦琪来到了山坡上，我拿出小木镐，开始挖土块。"咚咚咚"，土块一块一块地被我挖了下来。我们用泥土垫脚，把入口修成阶梯，方便上下。

  麦琪在旁边帮我整理挖出来的方块，她说："杰杰，我们挖了好多土块啊！"她还在笔记本上画了一个矿车轨道计划，准备以后放矿车。

  我继续往下挖，突然，"叮"的一声，我挖到了一块石头！我兴奋地说："麦琪，你看，我挖到石头了！"接着又遇到了煤炭，我们赶紧合成石镐和更多火把。

  麦琪也很高兴，说："太好了！石头可以做石镐，石镐比木镐更厉害！"她提议先做一把石剑，以防遇到洞穴蜘蛛。

  我们继续往下挖，挖着挖着，我发现前面有三条路：一条路继续往下，看起来很深，好像通到地下峡谷；一条路往左，有暖色的光闪烁，可能是岩浆或发光的红石；一条路往右，我听到有"滴答滴答"的水声，也许是地下河，还能听见蝙蝠振翅。每条路都像一扇等待被打开的门。

- **结尾，引导到选择的口播**：
  小冒险家，挖矿的时候遇到分岔路，你觉得我们应该往哪边走呢？

---

[O5-1 选项文本]
"我们决定继续往下挖，看看能不能挖到更深的矿石。"

[K5-1 插播文本]
  往更深的矿洞走，就像翻开一本更厚的冒险书——越往下越容易发现稀有矿石，但也越需要冷静。我们要边挖边插火把、随手放标记，确保随时能找到回家的路。现实里的学习也是如此：想把钢琴弹好、把拼图拼完，就要一点点坚持下去。只要注意安全，深入探索会带来很多惊喜。准备好了吗？回到选择里想想你会怎么做。

---

[O5-2 选项文本]
"我们决定往左边有亮光的地方走，看看是什么在发光。"

[K5-2 插播文本]
  看到远处有亮光，先别慌，可能是岩浆，也可能是之前探险家留下的火把。靠近前先铺好石砖、准备好水桶，就能在安全距离里观察。生活中遇到陌生环境也一样，要看看那里是不是人多明亮、有大人在，确认安全再前进。保持好奇心的同时也要保持警觉，这样探索才更有趣。现在，我们回到选择上，你想往哪边走？

---

[O5-3 选项文本]
"我们决定往右边有水声的地方走，看看能不能找到水源。"

[K5-3 插播文本]
  “滴答滴答”的声音很可能是地下河或瀑布，那里通常有黏土、发光墨囊，甚至隐藏的洞穴。我们可以顺着声音走，但要先准备好船或梯子，防止被水冲走。现实生活里，水同样珍贵：我们每天洗手、浇花都要记得关紧水龙头，不浪费每一滴。学会寻找和爱护水源，冒险就更安心啦。回到选择里，你会怎么决定呢？

---

- **跳转说明**：
  - 如果选择 O5-1 → 跳转到挖矿分支的后续节点（可按需求扩展）
  - 如果选择 O5-2 → 跳转到挖矿分支的后续节点（可按需求扩展）
  - 如果选择 O5-3 → 跳转到挖矿分支的后续节点（可按需求扩展）

---

### [M6 主线剧情（村庄社交分支 - 带选项）]

- **类型**：M（带选项）

- **文本（口播稿）**：
  我和麦琪来到了村庄，哇，这里好热闹啊！有好多小房子，还有村民在走来走去。铁匠铺传来“当当当”的声音，农田里种满了胡萝卜和小麦。

  一个村民看到我们，友好地挥了挥手。麦琪兴奋地说："杰杰，你看，他们在和我们打招呼呢！"她赶紧把背包里的苹果拿出来，当作见面礼。

  我走过去，村民说："你好，欢迎来到我们的村庄！"我高兴地说："你好！我们是新来的，想在这里看看。"

  村民笑了笑，说："当然可以！我们村庄有很多有趣的地方，你们可以去商店看看，也可以去农场帮忙，还可以去图书馆学习。今晚还有篝火晚会，欢迎你们留下来讲故事。"

  麦琪问我："杰杰，你想先去哪里呢？要不要先帮忙干点活，晚会才有东西分享？"

- **结尾，引导到选择的口播**：
  小冒险家，在村庄里有很多有趣的地方，你觉得我们应该先去哪里呢？

---

[O6-1 选项文本]
"我们决定去商店看看，看看能不能交换一些有用的物品。"

[K6-1 插播文本]
  进入商店，就能学到“我有你没有，你有我想要”的交换魔法。我们用木板换面包，老板也得到他需要的材料，大家都笑眯了眼。生活里和朋友分享贴纸、互换玩具，其实也是一种小小交易。懂得分享，就更容易交到朋友。现在我们回到选择里，你想怎么做呢？

---

[O6-2 选项文本]
"我们决定去农场帮忙，看看能不能学到一些种植的知识。"

[K6-2 插播文本]
  农场里的每一粒种子都需要有人浇水、除草、等待，它们才会长成胡萝卜或小麦。我们帮忙劳动，不但能让田地更整洁，还能学到“付出→收获”的节奏。现实里帮爸爸妈妈洗碗、擦桌子，也会得到“谢谢”和满满成就感。劳动真的会带来快乐哦！回到选择里，你会怎么选？

---

[O6-3 选项文本]
"我们决定去图书馆学习，看看能不能学到一些新知识。"

[K6-3 插播文本]
  图书馆就像宝箱，里面藏着各种教程：教你怎么驯服马、怎样做红石机关。翻开一本书，就好像得到一位老师在耳边悄悄指导。现实生活中，我们读故事书、科普书，也是在为自己储存好主意。知识越多，冒险就越精彩。现在回到选择里，决定一下要不要去图书馆吧？

---

- **跳转说明**：
  - 如果选择 O6-1 → 跳转到 M7（继续村庄社交分支）
  - 如果选择 O6-2 → 跳转到 M8（继续村庄社交分支）
  - 如果选择 O6-3 → 跳转到 M9（继续村庄社交分支）

---

### [M7 主线剧情（村庄社交分支 - 线性）]

- **类型**：M（线性无选项）

- **文本（口播稿）**：
  我和麦琪来到了商店，商店老板热情地欢迎我们。他说："欢迎光临！我这里有很多好东西，你们可以用绿宝石来交换。"

  我看了看商店里的物品，有面包、有工具、还有各种有用的东西。麦琪说："杰杰，我们虽然没有绿宝石，但我们可以用我们收集的木头和村民交换啊！"

  商店老板听了，笑着说："好主意！我很乐意和你们交换。"于是，我们用一些木头换到了面包和一把小铁剑。他又掏出一张小地图，说只要我们帮忙把后院的杂草清理掉，就把地图送给我们。

  麦琪高兴地说："太好了！现在我们有了食物和武器，还可以接任务啦！"我们帮他清理完杂草，真的得到了一张标记远方矿洞的地图。

  我们和商店老板告别，继续在村庄里探索。今天真是收获满满的一天！等晚上围着篝火时，我们还能把地图给新朋友看。

- **跳转说明**：本段为线性播放，无选项，故事在此结束（如需继续，可跳转到下一个带选项的M节点）。

---

### [M8 主线剧情（村庄社交分支 - 线性）]

- **类型**：M（线性无选项）

- **文本（口播稿）**：
  我们来到村庄的农场，玛丽姨妈正忙着把小麦捆成一捆一捆。她看到我们，笑着说：“呀，杰杰和麦琪，你们来的正好，能不能帮我浇一下胡萝卜，还要把成熟的土豆收进仓？”

  我拿起木桶，从水井里打水，沿着田垄一点点浇灌。麦琪则戴上稻草帽，用木锄把土松一松，顺便采下一篮橙橙的胡萝卜。咕噜跑着跑着，一屁股坐进干草堆里，惹得我们哈哈大笑。

  忙完后，玛丽姨妈送给我们一袋种子，还教我们辨认“干土”和“湿土”的差别。她说：“旅行时，只要有种子和一点水，就能种出新的食物。”我们把种子 carefully 装进背包，准备带去下一个营地。

- **跳转说明**：本段为线性播放，无选项，故事在此结束（如需继续，可跳转到下一个带选项的M节点）。

---

### [M9 主线剧情（村庄社交分支 - 线性）]

- **类型**：M（线性无选项）

- **文本（口播稿）**：
  我们推开图书馆的大门，里面安安静静，书架高得快碰到天花板。图书管理员托比爷爷戴着圆圆的眼镜，他说：“想学什么就自己找，记得轻轻翻页。”

  麦琪找到一本《矿洞里的奇怪声音》，我则抱着《如何制作附魔书》坐到窗边。阳光透过玻璃，落在我们打开的书页上，字像在发光。我还在墙上的大地图前面停了一下，把我们走过的路线用小贴纸标示出来。

  临走时，托比爷爷借给我们一盏阅读灯，还叮嘱：“冒险很精彩，但别忘了记录，你们的故事就是最棒的书。”我们点点头，把阅读灯放进背包，觉得知识也像装备一样重要。

- **跳转说明**：本段为线性播放，无选项，故事在此结束（如需继续，可跳转到下一个带选项的M节点）。

---

## 说明

本脚本采用完全分支型结构，不同选择会进入完全不同的故事分支：
- **分支1（森林探索）**：M1 → M2 → M3 → M4（后续节点可继续扩展）
- **分支2（挖矿冒险）**：M1 → M5 → （可继续扩展）
- **分支3（村庄社交）**：M1 → M6 → M7/M8/M9 → （可继续扩展）

每个分支都有独立的故事线，互不干扰，为小听众提供丰富的探索可能性。
