helper15901590/game-story/V1.0 选项插播 20251125/其他资料/村庄任务/minecraft_story_script.md

# 我们的方块冒险：杰杰、麦琪、睿睿与小七

[M1 主线剧情（带选项）]  
我是杰杰，是翡翠村的守护小冒险家，麦琪是我的好搭档。今天一大早，村庄的钟楼“当当当”敲了三下，村长说今天是“村庄帮忙日”，大家都要一起帮忙做事情。我背上铁锄，麦琪背上音符盒，叫上学徒睿睿和他弟弟小七，一起绕村子走一圈看看谁需要我们。  

我们先路过小麦田，农夫大叔正挠头：“哎呀，今天要收麦子，可是稻草人坏了，吓不走小鸡。”再往前走，图书馆的老学者阿姨也站在门口：“唉，我想给孩子们讲故事，可是书都乱七八糟，找不到喜欢看的那一本。”村口的小河边，还停着一条快散架的小船，渔夫叔叔对着洞洞叹气。  

我站在小路中央，挠挠脑袋：“要是我能分身就好了，大家我都想帮。”麦琪拍拍我：“那就先选一件最着急的，我们一步一步来。”这时睿睿举起他的小笔记本：“杰杰，我们可以先去最远的地方，路上顺便观察别的事情。”小七却抱着一篮胡萝卜跳起来：“不要啦，我想先去看小动物，看看有没有小羊宝宝！”  

我深呼吸，对着正在听故事的小朋友说：“那我们得先做一个选择，看看今天的帮忙从哪里开始。”  
- **引导口播**：  
  “你会怎么选？是先去田里帮农夫修好稻草人，还是先去村口帮渔夫修小船？”

  [O1-1 选项文本]  
  “先去小麦田帮忙，看看能不能做一个厉害的稻草人守护队。”  

  [O1-2 选项文本]  
  “先去河边帮忙修小船，看看能不能给小船做一点有趣的小机关。”  

- **跳转说明**：  
  - 如果选择 O1-1 → 跳转到 M2（线性分支，之后汇聚到 M4）  
  - 如果选择 O1-2 → 跳转到 M3（线性分支，之后汇聚到 M4）

---

[M2 主线剧情]  
我们四个人一边跑一边挥手，对农夫大叔喊：“我们来帮忙啦！”小麦田边上站着一个软趴趴的旧稻草人，帽子歪到一边，裤子掉了一只裤腿，小鸡根本不怕它，叽叽喳喳在麦田里乱跑。农夫大叔有点着急：“要是今天收不完，小麦会被踩坏的。”  

我把铁锄往地上一插，说：“交给我们吧，我们做一个超酷的‘方块稻草人守护队’。”麦琪马上拿出彩色羊毛和木板，跟我一起搭高高的稻草人塔。睿睿负责画图，把稻草人画成各种表情：有瞪大眼的、有吐舌头的，还有一个戴着南瓜头。小七最开心，他拿着种子在稻草人脚边画小脚印，一边学稻草人说话：“喂，小鸡，请走小路。”  

我们一边搭，一边在地上放上红石灯，调成晚上会一闪一闪。“这样小鸡晚上也会乖乖回家。”我一边说，一边试着学大公鸡“喔喔喔”叫。等全部做好，我们退到一边，看着新稻草人排成一队，像一支守护小队。小鸡真的有点害怕了，开始往鸡舍那边挤。农夫大叔笑得胡子一抖一抖：“太好了，等麦子收完，我要给你们每人一块南瓜派。”  

我看看天色，说：“今天是村庄帮忙日，我们不能只在一块田里待着，等会还要回集合点，看看别的地方需不需要我们。”麦琪点点头，把用剩下的彩色羊毛装进背包。  
- **跳转**：线性播放，结束后直接前往 M4

[M3 主线剧情]  
那我们先跑到河边。河水在阳光里闪闪亮，小鱼在方块水里吐泡泡，可小船边缘破了一个大洞，一摇一晃。渔夫叔叔抓着头发：“今天本来想带村里的孩子去河上看夕阳的，现在小船一坐就要‘咕咚’。”  

我蹲下来看了看：“这个简单，我们用木板和台阶把船加宽一点，再用栅栏做护栏，小朋友就安全多了。”麦琪负责把木板一块块接上，还在船头放了一个南瓜灯当“小船船长”。睿睿翻开小本子，一边记一边说：“船左边要多放两块，右边要留一条上船的路。”小七拿着桶在旁边试水，一边舀水一边喊：“不漏了！这边不漏了！”  

修好以后，我提议：“既然是村庄帮忙日，我们干脆把它变成‘小朋友观光船’，在船边加一点有趣的东西。”于是我们在护栏上挂了几只铃铛，走路会“叮铃叮铃”；又在船尾接了一点红石，让灯可以一闪一闪像星星。渔夫叔叔满意地点头：“这样孩子们一定会喜欢的，谢谢你们。”  

我看着慢慢变得安静的河面，说：“我们还答应了别的村民，得回集合点继续帮忙。”麦琪把用剩的木板收好，我们一起往村中心跑去。  
- **跳转**：线性播放，结束后直接汇合到 M4

[M4 主线剧情（极短衔接，无选项）]  
没一会，我们都来到了村庄中心的大树下集合。那里有一张方块长椅，村长坐在那儿等我们，把今天要做的事情记在一块木牌上。我和麦琪擦擦手上的泥，睿睿合上他的小本子，小七把沾了泥巴的鞋在草地上蹭两下。我们围在大树下，准备听一个关于翡翠村的小小秘密。  
我提醒你：“如果想听一点村庄的小秘密，就按下亮灯的按钮；如果不想听也没关系，我们马上继续做下一件帮忙的事情。”  
[K4 插播文本]  
- **内容**：麦琪从大树的树洞里拿出一本旧旧的“翡翠村小日志”，上面画着很多小图案：有一只被稻草人吓得跳起来的小鸡，有一条刚修好的小船，还有一行小字写着‘每天帮别人一点点，村庄就会亮一点点’。睿睿发现，日志边角还画着一张小地图，标着‘适合小朋友玩的安全路线’，专门绕开深坑和仙人掌。小七用手指点着地图说：“原来大人早就偷偷帮我们画好了路。”  
- **结尾口播**：  
  “这个小秘密知道啦！原来我们在帮忙的时候，大人们也在偷偷守护我们。带着这张小地图，我们继续做下一件帮忙的事情吧。”

---

[M5 主线剧情（带选项）]  
现在我们从大树下出发，准备做今天最后一件大事情。村长看了看木牌，说还有两件事没完成：一件是给村里孩子搭一个新的游乐角，方便大家玩耍；另一件是帮图书馆整理故事屋，让喜欢安静的小朋友有地方听故事。太阳慢慢往下走，时间不多了，我们只能先完成其中一件。  

- **方案A：热闹方块游乐角**。我负责在空地上用木板、楼梯和史莱姆块搭一个小小跳跳床和滑梯；麦琪负责用音符盒做“开始音乐”，一按按钮就会响。睿睿当安全检查员，拿着小本子记哪儿需要多放一块栏杆；小七负责试玩，每玩一个就大喊“这个好好玩！”  

- **方案B：安静故事小屋**。我们在图书馆旁边的小房间铺上地毯，摆上软软的床和南瓜灯。麦琪负责把故事书按主题分好：一堆是动物故事，一堆是冒险故事，一堆是睡前故事。睿睿写上简单的符号，方便还不会认字的小朋友也能找到；小七当“故事小帮手”，负责发小垫子，让大家可以安静地坐着听。  

两个办法都很有用，可只能先选一个。村里的小朋友有的喊：“我要去跳跳床！”有的说：“我想听安静的故事！”村长笑眯眯地看着我们：“你们先选一个，明天我们可以再一起做另一件。”我和麦琪对视一下，把选择交给正在听故事的你。  
- **引导口播**：  
  “你来决定：我们是先搭热闹的方块游乐角，还是先布置安静的故事小屋？”

  [O5-1 选项文本]  
  “选择游乐角，让大家一起跳跳跳、滑滑梯，在广场上开玩耍派对。”  

  [O5-2 选项文本]  
  “选择故事小屋，让喜欢安静的小朋友先有一个软软的听故事地方。”  

- **跳转说明**：  
  - 如果选择 O2-1 → 跳转到 M6（独立分支，线性收束）  
  - 如果选择 O2-2 → 跳转到 M7（独立分支，线性收束）

---

[M6 主线剧情（线性结尾）]  
我把木板一块块搭起来，做成弯弯的滑梯和小桥；麦琪在旁边调试音符盒，“叮咚叮咚”的音乐一响，小朋友就知道可以开始玩了。睿睿跑来跑去，检查哪儿还要加栅栏：“这里要多一块，不然有人会‘哎哟’摔下去。”小七负责试玩，他跳上史莱姆块“蹦蹦蹦”，又滑下滑梯，一边笑一边大喊：“这个合格！这个也合格！”  

太阳快要落山的时候，游乐角终于搭好了。村里的孩子一队队排队玩，有的在滑梯上“咻——”滑下来，有的在跳跳床上“啪啪啪”落地。大人们站在一旁聊天，看着我们说：“有你们这些小帮手，村庄真热闹。”我站在一旁擦汗，心里暖暖的。  
村长在地上画了一个小小的勾：“今天的帮忙日，游乐角这件事，完成！”  
- **回顾**：我们一起动手搭了游乐角，让喜欢跑跳的小朋友有了新的玩耍地方，也学会了注意安全、轮流玩。  
- **说明**：线性播放至此结束（无 E 节点）

[M7 主线剧情（线性结尾）]  
我们先把地毯铺得软软的，又把南瓜灯点亮成暖黄色的灯光。麦琪抱来一大摞书，小心地分成几堆：“这一堆是动物的，这一堆是冒险的，这一堆是睡前的。”睿睿拿出他的小本子，在书架上贴上简单的符号：一只小爪印代表动物，一把小剑代表冒险，一轮小月亮代表睡前。  

小七当“故事小帮手”，他把小垫子一块一块排好，对来的小朋友说：“想听故事就坐在这条地毯上，轮到你选书的时候再站起来。”很快，房间里坐满了认真的小脸蛋，大家把声音放得轻轻的，只听得到翻书“沙沙”的声音。老学者阿姨推了推眼镜，笑着说：“有了你们，我可以一次给好多孩子讲故事了。”  

等到第一轮故事讲完，窗外的天刚好变成橙色。村长在门口看着我们：“故事小屋完成，今天喜欢安静的小朋友也有了自己的地方。”我伸了个大大大懒腰，觉得今天虽然很累，但心里像被阳光晒过一样舒服。  
- **回顾**：我们一起整理了故事小屋，让喜欢安静的小朋友有了听故事的角落，也学会了排队、轻声说话。  
- **说明**：线性播放至此结束（无 E 节点）
