helper15901590/game-story/V1.0 选项插播 20251125/其他资料/小红帽-主线、选项、插播、结局音频V2.0/小红帽故事脚本-线性播放版.pdf

⼩红帽故事脚本-线性播放版.md | 2025-11-12

1 / 2

# ⼩红帽互动⾳频故事脚本 - 线性播放版

## 故事概述

故事名称: ⼩红帽
故事类型: 安全与⽣活习惯类
结构特点: M1分⽀选择 → M2/M3线性播放 → M4决策点 → 多结局

## 主线剧情

### M1: 出发前的叮嘱

故事: "很久很久以前！在⼀个阳光明媚的早晨，妈妈把⼀个装满新鲜出炉的蛋糕和黄油的篮⼦交给了⼩红 帽。'亲爱的，'她温柔地说，'外婆⽣病了，你把这些带给她。记住，⼀定要沿着宽阔的⼤路⾛，那⾥⼈多安 全。千万不要贪玩跑进森林，更不要和任何陌⽣⼈说话。'请旋转旋钮选择剧情，并按下确认按钮。"

决策点:

选项 (O1): "可是妈妈，森林⾥的⼩路近多了……"
(K1): "⼩贴⼠：你知道吗？！选择捷径有时能节省时间，但也可能遇到意想不到的危险，因为偏僻 的地⽅缺少保护和求助的机会。"
主线: "跳转到 M3"
选项 (O2): ⼩红帽说，"好的妈妈，我会⾛⼤路的。"
(K2): "⼩贴⼠：⼩冒险家你要记住，⼈来⼈往的⼤路，通常比偏僻的⼩路更安全，因为周围⼈多， 坏⼈不敢轻易出现，也更容易求助。"
主线: "跳转到 M2"

### M2: ⼤路上的帮助

故事: "⼩红帽⾛在宽阔的⼤路上，路上有许多⾏⼈，她还和⼏个认识的⼩伙伴打了招呼。⾛着⾛着，她不⼩⼼ 被⼀块⽯头绊倒，篮⼦⾥的蛋糕滚了出来。⼀位看起来很和善的阿姨急忙上前，帮她把蛋糕捡起来，拍掉上⾯ 的灰尘，放回了篮⼦⾥。这位阿姨微笑着问：'⼩朋友，你没事吧？你⼀个⼈要去哪⾥呀？'⼩红帽想起妈妈的 话，礼貌地说：'谢谢阿姨，我没事。'然后继续向前⾛去。"

决策点: ⽆选项
线性播放: 直接跳转到 M4（展⽰主⾳频连读功能）

### M3: ⼩路上的遭遇

故事: "⼩红帽为了快点到外婆家，选择了森林⾥的⼩路。路边开满了美丽的野花，她忍不住摘了⼀些。就在这 时，⼀只⼤灰狼从树林⾥窜了出来，挡住了她的去路。'可爱的⼩姑娘，'⼤灰狼说，'你这么着急，是要到哪⾥ 去呀？'⼩红帽吓了⼀跳，想起妈妈的话，立刻转⾝，⽤尽全⾝⼒⽓跑回了⼤路。"

决策点: ⽆选项
线性播放: 直接跳转到 M4（展⽰主⾳频连读功能）

⼩红帽故事脚本-线性播放版.md | 2025-11-12

2 / 2

### M4: 最后的抉择

故事: "⼩红帽终于来到了外婆家附近。她看到外婆的⼩屋就在不远处，但⼩屋的⻔半开着，⾥⾯似乎有些不对 劲。⼩红帽⼼⾥有些不安，她应该怎么办呢？请旋转旋钮选择剧情，并按下确认按钮。"

决策点:

选项 (O1): ⼩红帽想："可能是外婆忘记关⻔了，我直接进去吧。"
(K1): "⼩贴⼠：当发现异常情况时，不要贸然⾏动。直接进入可能有危险的地⽅，可能会让⾃⼰陷 入困境。"
主线: "跳转到 E3"
选项 (O2): ⼩红帽想："我先在⻔外喊⼀声，看看外婆是否在家。"
(K2): "⼩贴⼠：在进入⼀个可能有异常的地⽅之前，先通过声⾳确认情况，是⼀个既礼貌⼜安全的 做法。"
主线: "跳转到 E2"
选项 (O3): ⼩红帽想："这⾥不对劲，我应该去找附近的猎⼈叔叔帮忙。"
(K3): "⼩贴⼠：当感觉到危险时，不要独⾃⾯对，向有能⼒提供帮助的成年⼈求助，是保护⾃⼰和 他⼈的明智选择。"
主线: "跳转到 E1"

## 结局阶段

### E1: 胜利结局

结局: "凭借⼩红帽的智慧和⼤家的帮助，成功抓住了⼤灰狼，救出了外婆，村庄⼜恢复了平静。保持警惕，并 善于向他⼈求助，是战胜危险的关键。从此以后，⼩红帽更加⼩⼼谨慎，村庄也变得更加安全。"

### E2: 平安结局

结局: "虽然经历了⼀些波折和惊吓，但⼩红帽和外婆最终都安然⽆恙，享受了团聚的时光。时刻遵守安全规 则，即使路上遇到⼀点⼩⿇烦，也能保证⾃⼰最终平安。祖孙⼆⼈⼀起分享了美味的蛋糕，度过了美好的下 午。"

### E3: 失败结局

结局: "因为⼀时的疏忽或错误的决定，⼩红帽陷入了危险之中，这是⼀个深刻的教训。⼀时的贪玩和疏忽，可 能会带来意想不到的后果。记住这次教训，下次冒险⼀定会更顺利！这次经历让她明⽩，听从⻓辈的建议是多 么重要。"

## 剧终⾳效

"冒险结束了，我的朋友...这真是⼀次愉快的冒险之旅，期待下次与你相⻅，再⻅。"

A2:04:00:01:07:00,A2:05:02:03:02:00,A2:06:00:04:00:00,A2:07:00:04:00:00,A2:08:03:07:06:05,A2:09:00:00:00:00,A2 :0A:00:00:00:00,A2:0B:00:00:00:00,
