helper15901590/game-story/V1.0 选项插播 20251125/其他资料/村庄任务/minecraft_story_script.pdf

minecraft_story_script.md | 2025-12-03

# 我们的⽅块冒险：杰杰、麦琪、睿睿与⼩七

[M1 主线剧情（带选项）]
我是杰杰，是翡翠村的守护⼩冒险家，麦琪是我的好搭档。今天⼀⼤早，村庄的钟楼“当当当”敲了三下，村⻓ 说今天是“村庄帮忙⽇”，⼤家都要⼀起帮忙做事情。我背上铁锄，麦琪背上⾳符盒，叫上学徒睿睿和他弟弟⼩ 七，⼀起绕村⼦⾛⼀圈看看谁需要我们。

我们先路过⼩麦⽥，农夫⼤叔正挠头：“哎呀，今天要收麦⼦，可是稻草⼈坏了，吓不⾛⼩鸡。”再往前⾛，图 书馆的老学者阿姨也站在⻔⼝：“唉，我想给孩⼦们讲故事，可是书都乱七八糟，找不到喜欢看的那⼀本。”村 ⼝的⼩河边，还停着⼀条快散架的⼩船，渔夫叔叔对着洞洞叹⽓。

我站在⼩路中央，挠挠脑袋：“要是我能分⾝就好了，⼤家我都想帮。”麦琪拍拍我：“那就先选⼀件最着急的， 我们⼀步⼀步来。”这时睿睿举起他的⼩笔记本：“杰杰，我们可以先去最远的地⽅，路上顺便观察别的事 情。”⼩七却抱着⼀篮胡萝⼘跳起来：“不要啦，我想先去看⼩动物，看看有没有⼩⽺宝宝！”

我深呼吸，对着正在听故事的⼩朋友说：“那我们得先做⼀个选择，看看今天的帮忙从哪⾥开始。”

引导⼝播：
“你会怎么选？是先去⽥⾥帮农夫修好稻草⼈，还是先去村⼝帮渔夫修⼩船？”

[O1-1 选项文本]
“先去⼩麦⽥帮忙，看看能不能做⼀个厉害的稻草⼈守护队。”

[O1-2 选项文本]
“先去河边帮忙修⼩船，看看能不能给⼩船做⼀点有趣的⼩机关。”

跳转说明：

如果选择 O1-1 → 跳转到 M2（线性分⽀，之后汇聚到 M4） 如果选择 O1-2 → 跳转到 M3（线性分⽀，之后汇聚到 M4）

[M2 主线剧情]
我们四个⼈⼀边跑⼀边挥⼿，对农夫⼤叔喊：“我们来帮忙啦！”⼩麦⽥边上站着⼀个软趴趴的旧稻草⼈，帽⼦ 歪到⼀边，裤⼦掉了⼀只裤腿，⼩鸡根本不怕它，叽叽喳喳在麦⽥⾥乱跑。农夫⼤叔有点着急：“要是今天收不 完，⼩麦会被踩坏的。”

我把铁锄往地上⼀插，说：“交给我们吧，我们做⼀个超酷的‘⽅块稻草⼈守护队’。”麦琪⻢上拿出彩⾊⽺⽑和⽊ 板，跟我⼀起搭⾼⾼的稻草⼈塔。睿睿负责画图，把稻草⼈画成各种表情：有瞪⼤眼的、有吐舌头的，还有⼀ 个戴着南瓜头。⼩七最开⼼，他拿着种⼦在稻草⼈脚边画⼩脚印，⼀边学稻草⼈说话：“喂，⼩鸡，请⾛⼩ 路。”

我们⼀边搭，⼀边在地上放上红⽯灯，调成晚上会⼀闪⼀闪。“这样⼩鸡晚上也会乖乖回家。”我⼀边说，⼀边 试着学⼤公鸡“喔喔喔”叫。等全部做好，我们退到⼀边，看着新稻草⼈排成⼀队，像⼀⽀守护⼩队。⼩鸡真的 有点害怕了，开始往鸡舍那边挤。农夫⼤叔笑得胡⼦⼀抖⼀抖：“太好了，等麦⼦收完，我要给你们每⼈⼀块南 瓜派。”

我看看天⾊，说：“今天是村庄帮忙⽇，我们不能只在⼀块⽥⾥待着，等会还要回集合点，看看别的地⽅需不需 要我们。”麦琪点点头，把⽤剩下的彩⾊⽺⽑装进背包。

跳转：线性播放，结束后直接前往 M4

[M3 主线剧情]
那我们先跑到河边。河⽔在阳光⾥闪闪亮，⼩⻥在⽅块⽔⾥吐泡泡，可⼩船边缘破了⼀个⼤洞，⼀摇⼀晃。渔 夫叔叔抓着头发：“今天本来想带村⾥的孩⼦去河上看夕阳的，现在⼩船⼀坐就要‘咕咚’。”

我蹲下来看了看：“这个简单，我们⽤⽊板和台阶把船加宽⼀点，再⽤栅栏做护栏，⼩朋友就安全多了。”麦琪 负责把⽊板⼀块块接上，还在船头放了⼀个南瓜灯当“⼩船船⻓”。睿睿翻开⼩本⼦，⼀边记⼀边说：“船左边要 多放两块，右边要留⼀条上船的路。”⼩七拿着桶在旁边试⽔，⼀边舀⽔⼀边喊：“不漏了！这边不漏了！”

修好以后，我提议：“既然是村庄帮忙⽇，我们⼲脆把它变成‘⼩朋友观光船’，在船边加⼀点有趣的东⻄。”于是 我们在护栏上挂了⼏只铃铛，⾛路会“叮铃叮铃”；⼜在船尾接了⼀点红⽯，让灯可以⼀闪⼀闪像星星。渔夫叔 叔满意地点头：“这样孩⼦们⼀定会喜欢的，谢谢你们。”

我看着慢慢变得安静的河⾯，说：“我们还答应了别的村⺠，得回集合点继续帮忙。”麦琪把⽤剩的⽊板收好， 我们⼀起往村中⼼跑去。

跳转：线性播放，结束后直接汇合到 M4

[M4 主线剧情（极短衔接，⽆选项）]
没⼀会，我们都来到了村庄中⼼的⼤树下集合。那⾥有⼀张⽅块⻓椅，村⻓坐在那⼉等我们，把今天要做的事 情记在⼀块⽊牌上。我和麦琪擦擦⼿上的泥，睿睿合上他的⼩本⼦，⼩七把沾了泥巴的鞋在草地上蹭两下。我 们围在⼤树下，准备听⼀个关于翡翠村的⼩⼩秘密。
我提醒你：“如果想听⼀点村庄的⼩秘密，就按下亮灯的按钮；如果不想听也没关系，我们⻢上继续做下⼀件帮 忙的事情。”
[K4 插播文本]

内容：麦琪从⼤树的树洞⾥拿出⼀本旧旧的“翡翠村⼩⽇志”，上⾯画着很多⼩图案：有⼀只被稻草⼈吓 得跳起来的⼩鸡，有⼀条刚修好的⼩船，还有⼀⾏⼩字写着‘每天帮别⼈⼀点点，村庄就会亮⼀点点’。睿 睿发现，⽇志边⾓还画着⼀张⼩地图，标着‘适合⼩朋友玩的安全路线’，专⻔绕开深坑和仙⼈掌。⼩七⽤ ⼿指点着地图说：“原来⼤⼈早就偷偷帮我们画好了路。”
结尾⼝播：
“这个⼩秘密知道啦！原来我们在帮忙的时候，⼤⼈们也在偷偷守护我们。带着这张⼩地图，我们继续做 下⼀件帮忙的事情吧。”

[M5 主线剧情（带选项）]
现在我们从⼤树下出发，准备做今天最后⼀件⼤事情。村⻓看了看⽊牌，说还有两件事没完成：⼀件是给村⾥ 孩⼦搭⼀个新的游乐⾓，⽅便⼤家玩耍；另⼀件是帮图书馆整理故事屋，让喜欢安静的⼩朋友有地⽅听故事。 太阳慢慢往下⾛，时间不多了，我们只能先完成其中⼀件。

⽅案A：热闹⽅块游乐⾓。我负责在空地上⽤⽊板、楼梯和史莱姆块搭⼀个⼩⼩跳跳床和滑梯；麦琪负责 ⽤⾳符盒做“开始⾳乐”，⼀按按钮就会响。睿睿当安全检查员，拿着⼩本⼦记哪⼉需要多放⼀块栏杆； ⼩七负责试玩，每玩⼀个就⼤喊“这个好好玩！”

⽅案B：安静故事⼩屋。我们在图书馆旁边的⼩房间铺上地毯，摆上软软的床和南瓜灯。麦琪负责把故事 书按主题分好：⼀堆是动物故事，⼀堆是冒险故事，⼀堆是睡前故事。睿睿写上简单的符号，⽅便还不 会认字的⼩朋友也能找到；⼩七当“故事⼩帮⼿”，负责发⼩垫⼦，让⼤家可以安静地坐着听。

两个办法都很有⽤，可只能先选⼀个。村⾥的⼩朋友有的喊：“我要去跳跳床！”有的说：“我想听安静的故 事！”村⻓笑眯眯地看着我们：“你们先选⼀个，明天我们可以再⼀起做另⼀件。”我和麦琪对视⼀下，把选择交 给正在听故事的你。

引导⼝播：
“你来决定：我们是先搭热闹的⽅块游乐⾓，还是先布置安静的故事⼩屋？”

[O5-1 选项文本]
“选择游乐⾓，让⼤家⼀起跳跳跳、滑滑梯，在⼴场上开玩耍派对。”

[O5-2 选项文本]
“选择故事⼩屋，让喜欢安静的⼩朋友先有⼀个软软的听故事地⽅。”

跳转说明：

如果选择 O2-1 → 跳转到 M6（独立分⽀，线性收束） 如果选择 O2-2 → 跳转到 M7（独立分⽀，线性收束）

[M6 主线剧情（线性结尾）]
我把⽊板⼀块块搭起来，做成弯弯的滑梯和⼩桥；麦琪在旁边调试⾳符盒，“叮咚叮咚”的⾳乐⼀响，⼩朋友就 知道可以开始玩了。睿睿跑来跑去，检查哪⼉还要加栅栏：“这⾥要多⼀块，不然有⼈会‘哎哟’摔下去。”⼩七负 责试玩，他跳上史莱姆块“蹦蹦蹦”，⼜滑下滑梯，⼀边笑⼀边⼤喊：“这个合格！这个也合格！”

太阳快要落⼭的时候，游乐⾓终于搭好了。村⾥的孩⼦⼀队队排队玩，有的在滑梯上“咻——”滑下来，有的在 跳跳床上“啪啪啪”落地。⼤⼈们站在⼀旁聊天，看着我们说：“有你们这些⼩帮⼿，村庄真热闹。”我站在⼀旁擦 汗，⼼⾥暖暖的。
村⻓在地上画了⼀个⼩⼩的勾：“今天的帮忙⽇，游乐⾓这件事，完成！”

回顾：我们⼀起动⼿搭了游乐⾓，让喜欢跑跳的⼩朋友有了新的玩耍地⽅，也学会了注意安全、轮流 玩。
说明：线性播放⾄此结束（⽆ E 节点）

[M7 主线剧情（线性结尾）]
我们先把地毯铺得软软的，⼜把南瓜灯点亮成暖黄⾊的灯光。麦琪抱来⼀⼤摞书，⼩⼼地分成⼏堆：“这⼀堆是 动物的，这⼀堆是冒险的，这⼀堆是睡前的。”睿睿拿出他的⼩本⼦，在书架上贴上简单的符号：⼀只⼩爪印代 表动物，⼀把⼩剑代表冒险，⼀轮⼩⽉亮代表睡前。

⼩七当“故事⼩帮⼿”，他把⼩垫⼦⼀块⼀块排好，对来的⼩朋友说：“想听故事就坐在这条地毯上，轮到你选书 的时候再站起来。”很快，房间⾥坐满了认真的⼩脸蛋，⼤家把声⾳放得轻轻的，只听得到翻书“沙沙”的声⾳。 老学者阿姨推了推眼镜，笑着说：“有了你们，我可以⼀次给好多孩⼦讲故事了。”

等到第⼀轮故事讲完，窗外的天刚好变成橙⾊。村⻓在⻔⼝看着我们：“故事⼩屋完成，今天喜欢安静的⼩朋友 也有了⾃⼰的地⽅。”我伸了个⼤⼤⼤懒腰，觉得今天虽然很累，但⼼⾥像被阳光晒过⼀样舒服。

回顾：我们⼀起整理了故事⼩屋，让喜欢安静的⼩朋友有了听故事的⾓落，也学会了排队、轻声说话。 说明：线性播放⾄此结束（⽆ E 节点）
