helper15901590/game-story/V1.0 选项插播 20251125/NFC写入教程/NFC数据结构251016.xlsx

Sheet: 1.NFC编码规则
NFC通信类型：ISO 14443-3A NFC型号：NTAG216 （国产868字节，进口888字节） 密码：0x31 0x35 0x39 0x30（1590） 验证码：0x32 0x32（22）
扇区地址（addr）十六进制 | 对应主故事线 |  | 存储数据(16进制：00-FF)
 | 主剧情编码 | M类音频编号
00——03 | / | / | UID以及厂家信息
04 |  |  | TF中对应的故事编号（只有此为十进制）：如，1299号 |  | 主音频数量
 |  |  | 高位：如，12 | 低位：如，99 | 高位：如，1B （此区块记录主音频数量） | 低位：00 （此区块因扇区数量限制，只能为00）
05 | M1 | 01 | M1的O类音频数量：（00-03） （如，03） | O1跳转M音频编号：（00-FF） （如，02） 1.当选项音频数量为00的时候，这个区块保存跳转主音频编号（00-FF）； 2.当此区块和选项音频数量都为00时，表示结束音频，播完直接跳到系统音。 | O2跳转M音频编号： （如，03） | O3跳转M音频编号： （如，04） | 1B:31:35:39:30,A2:04:00:02:07:00,A2:05:03:02:05:06,A2:06:03:03:03:03,A2:07:00:04:00:00,A2:08:03:05:05:05,A2:09:03:06:06:06,A2:0A:03:07:08:09,A2:0B:00:00:00:00,A2:0C:00:00:00:00,A2:0D:00:00:00:00
06 | M2 | 02
07 | M3 | 03
08 | M4 | 04
09 | M5 | 05
0A | M6 | 06
0B | M7 | 07
0C | M8 | 08
0D | M9 | 09
0E | M10 | 10
0F | M11 | 11
10 | M12 | 12
11 | M13 | 13
12 | M14 | 14
... | ... | ...
E3 | 密码命令 |  | 04 | 00 | 00 | 00
E4 | 密码错误机制（试错次数） |  | 00 | 05 | 00 | 00
E5 | E5(密码保存区域) |  | 0X31 | 0X35 | 0X39 | 0X30
E6 | E6（验证码区域） |  | 0X32 | 0X32 | 0X00 | 0X00

Sheet: 2.TF卡音频命名规则
TF存储格式文件内语音命名格式(支持 MP3 和 WAV 格式; 支持采样率 8K-44.1K，单声道音频码率支持 8kbps~320kbps。
根目录名称 | 命名规则（以0开头，共4位，十进制）
SYSTE（大写） | 音频类型 | 6-12岁 | 3-5岁 | 间隔时长
 | 开机 | 1001 | 2001 | 6-12岁
 | 关机 | 1002 | 2002
 | 音量调节 | 1003 | 2003
 | 读卡错误 | 1004 | 2004
 | 读卡正确 | 1005
 | 拔卡 | 1006
 | 跳过主音频 | 1007
 | 电量≤20%时 | 1008 | 2005
 | 电量≤10%时 | 1009
 | 剧终 | 1010
00001 (第一位永远为0，其他位与NFC 04扇区对应） | 主线故事编码 | M类主音频编号 （3位：001-999） | O类选项音频编号 （1位：0-3） | K类插播音频编号
 | M1 | 0010 | O1为0011，O3为0013
 | M2 | 0020 | O1为0021，O2为0022

Sheet: 小红帽
NFC通信类型：ISO 14443-3A NFC型号：NTAG216 （国产868字节，进口888字节） 密码：0x31 0x35 0x39 0x30（1590） 验证码：0x32 0x32（22）
扇区地址（addr）十六进制 | 对应主故事线 |  | 存储数据(16进制：00-FF)
 | 主剧情编码 | M类音频编号
00——03 | / | / | UID以及厂家信息
04 |  |  | TF中对应的故事编号（只有此为十进制）：如，1299号 |  | 主音频数量
 |  |  | 高位：如，12 | 低位：如，99 | 高位：如，1B （此区块记录音频数量） | 低位：00 （此区块因扇区数量限制，只能为00）
05 | M1 | 01 | M1的O类音频数量：（00-03） （如，03） | O1跳转M音频编号：（00-FF） （如，02） 1.当选项音频数量为00的时候，这个区块保存跳转主音频编号（00-FF）； 2.当此区块和选项音频数量都为00时，表示结束音频，播完直接跳到系统音。 | O2跳转M音频编号： （如，03） | O3跳转M音频编号： （如，04）
06 | M2 | 02
07 | M3 | 03
08 | M4 | 04
09 | M5 | 05
0A | M6 | 06
0B | M7 | 07
0C | M8 | 08
0D | M9 | 09
0E | M10 | 10
0F | M11 | 11
10 | M12 | 12
11 | M13 | 13
12 | M14 | 14
... | ... | ...
E3 | 密码命令 |  | 04 | 00 | 00 | 00
E4 | 密码错误机制（试错次数） |  | 00 | 05 | 00 | 00
E5 | E5(密码保存区域) |  | 0X31 | 0X35 | 0X39 | 0X30
E6 | E6（验证码区域） |  | 0X32 | 0X32 | 0X00 | 0X00
