helper15901590/game-story/V2.0 主音插播 20251213/[2]NFC编码及写入/NFC数据结构L2.0.xlsx

Sheet: 1.模式一NFC编码规则
NFC通信类型：ISO 14443-3A NFC型号：NTAG216 （国产868字节，进口888字节） 密码：0x31 0x35 0x39 0x30（1590） 验证码：0x32 0x32（22）
扇区地址（addr）十六进制 | 对应主故事线 |  | 模式一（6-9岁，有插播）
 | 主剧情编码 | M类音频编号
00——03 | / | / | UID以及厂家信息
04 |  |  | TF中对应的故事编号（只有此为十进制）：如，1001号 |  | M主音频数量（16进制 00-FF） | 默认00（无任何意义）
 |  |  | 高位：10 | 低位：01 | 如：20 表示32条主音频
区块 |  |  | block1 | block2 | block3 | block4
05 | M1 | 01 | M1的O类音频数量（00-03）：如，03； 若为00，则代表没有选项； 若首位为1，则代表该主音有插播，如13； | O1跳转M音频编号（00-FF）：如，02（M2） 若block1为00，则写跳转主音频编号（00-FF）； 若block1和此都为00时，则表示结束音频。 | O2跳转M音频编号：（如，03） | O3跳转M音频编号：（如，04）
06 | M2 | 02
... | ... | ...
0F | M11 | 11
10 | M12 | 12
... | ... | ...
E3 | 密码命令 |  | 04 | 00 | 00 | 00
E4 | 密码错误机制（试错次数） |  | 00 | 05 | 00 | 00
E5 | E5(密码保存区域) |  | 0X31 | 0X35 | 0X39 | 0X30
E6 | E6（验证码区域） |  | 0X32 | 0X32 | 0X00 | 0X00

Sheet: 2.TF卡音频命名规则
TF存储格式文件内语音命名格式(支持 MP3 和 WAV 格式; 支持采样率 8K-44.1K，单声道音频码率支持 8kbps~320kbps。
系统音效映射表
音频文件夹命名 第一位永远为'0' | 音频文件命名 | 音效类型 | 内容
IStory(6-9)
SYSTE（大写） | 1001 | 开机 | "冒险家你好，请插入卡片。"
 | 1002 | 关机 | “冒险结束了，下次再见！"
 | 1003 | 音量调节 | ”喂！能听见吗？！"
 | 1004 | 读卡错误 | "这不是我们的冒险卡片，快换一张吧！"
 | 1005 | 读卡正确 | "验证通过，冒险之门已为你打开！"
 | 1006 | 拔卡 | "冒险之门已关闭，期待再次相见！"
 | 1007 | 跳过主音频 | "咻...我们到啦！"
 | 1008 | 电量≤10%时 | "糟糕！我现在没电了！我得走了，再见！"
 | 1009 | 剧终 | "冒险结束了，我的朋友...这真是一次愉快的冒险之旅，期待下次与你相见，再见。"
00001 | 主线故事编码 | M类主音频编号 （3位：001-999） | O类选项音频编号 （1位：0-3） | K类音频编号（A）
 | M1 | 0010 | O1为0011，O3为0013 | 001A
 | M8 | 0080 | O1为0081，O3为0083 | 008A
