helper15901590/game-story/V1.0 选项插播 20251125/开发生产文件/故事机251117 L1.0/开发文件/语音/小红帽3.0/NFC数据结构.xlsx

Sheet: 系统音效
系统音效映射表
音频文件命名 | 音频应用
0001 | 开机 | "冒险家你好，请插入卡片。" | 1秒
0002 | 关机 | “冒险结束了，下次再见！" | /
0003 | 音量调节 | ”喂！能听见吗？！" | /
0004 | 读卡错误 | "这不是我们的冒险卡片，快换一张吧！" | /
0005 | 读卡正确 | "验证通过，冒险之门已为你打开！" | 3秒
0006 | 拔卡 | "冒险之门已关闭，期待再次相见！" | /
0007 | 跳过主音频 | "咻...我们到啦！" | 1秒
0008 | 等待=1&2min | "呼叫冒险家！收到请回答！" | /
0009 | 电量≤20%时 | "哎呀！我快没电了，快帮我充电！" | 1秒
0010 | 电量≤10%时 | "糟糕！我现在没电了！我得走了，再见！" | /
0011 | 剧终 | "冒险结束了，我的朋友...这真是一次愉快的冒险之旅，期待下次与你相见，再见。" | /

Sheet: 小红帽3.0
1
地址（addr16进制） | 存储数据（16进制） |  |  |  |  | 2 | 2
00——03 | UID以及厂家信息 |  |  |  |  | 3 | 3
04 | TF中对应的 故事编号高位10进制：00（小红帽） | TF中对应的 故事编号低位10进制：01（小红帽） | 主音频数量：06(M音频与E结束音频) | 00 |  | 4 | 4
05 | 02 | 03 | 02 | 00 | M1 | 5 | 5
06 | 00 | 04 | 00 | 00 | M2 | 6 | 6
07 | 00 | 04 | 00 | 00 | M3 | 7 | 7
08 | 03 | 07 | 06 | 05 | M4 | 8 | 8
09 | 00 | 00 | 00 | 00 | E1 | 9 | 9
10 | 00 | 00 | 00 | 00 | E2 | 10 | A
11 | 00 | 00 | 00 | 00 | E3 | 11 | B
12 |  |  |  |  | M8 | 12 | C
13 |  |  |  |  | M9 | 13 | D
14 |  |  |  |  | M10 | 14 | E
15 |  |  |  |  | M11 | 15 | F
16 |  |  |  |  | M12
17 |  |  |  |  | M13
18 |  |  |  |  | M14
19 |  |  |  |  | M15
20 |  |  |  |  | M16
21 |  |  |  |  | M17
22 |  |  |  |  | M18
23 |  |  |  |  | M19
24 |  |  |  |  | M20
25 |  |  |  |  | M21
26 |  |  |  |  | M22
27 |  |  |  |  | M23
28 |  |  |  |  | M24
29 |  |  |  |  | M25
30 |  |  |  |  | M26
31 |  |  |  |  | M27
32 |  |  |  |  | M28
33 |  |  |  |  | M29
34 |  |  |  |  | M30
35 |  |  |  |  | M31
36 |  |  |  |  | M32
37 |  |  |  |  | M33
38 |  |  |  |  | M34
39 |  |  |  |  | M35
40 |  |  |  |  | M36
41 |  |  |  |  | M37
42 |  |  |  |  | M38
43 |  |  |  |  | M39
44 |  |  |  |  | M40
45 |  |  |  |  | M41
46 |  |  |  |  | M42
47 |  |  |  |  | M43
48 |  |  |  |  | M44
49 |  |  |  |  | M45
50 |  |  |  |  | M46
51 |  |  |  |  | M47
52 |  |  |  |  | M48
53 |  |  |  |  | M49
54 |  |  |  |  | M50
55 |  |  |  |  | M51
56 |  |  |  |  | M52
57 |  |  |  |  | M53
58 |  |  |  |  | M54
59 |  |  |  |  | M55
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
219 |  |  |  |  | M215
220 |  |  |  |  | M216
221 |  |  |  |  | M217
222 |  |  |  |  | M218
223 |  |  |  |  | M219
224 |  |  |  |  | M220
225 |  |  |  |  | M221
E2
E3 | 04 | 00 | 00 | 00
E4 | 00 | 05 | 00 | 00
E5(密码保存区域) | 0X31 | 0X35 | 0X39 | 0X30
E6（验证码区域） | 0X32 | 0X32 | 0X00 | 0X00
