helper15901590/game-story/(list of files, drawings)

Other design files:
V1.0 选项插播 20251125/开发生产文件/故事机251117 L1.0/开发文件/硬件/Story_machine V1.3/Story_machine V1.31.PcbDoc
